CatLiZi/DeepSight-3D/docs/report/README.md

# 项目进度与评估报告

- [项目阶段汇报](index.html)：硬件、架构、算法及按时间保留的历史进展；页面顶部新增2026-11-05的R52互斥优先模式，历史章节保留原日期。
- [R52听声／视觉优先模式](primary-modes-r52.html)：声音主导与可打断视觉辅助、软件验证和两人现场复核步骤。
- [项目整体评估](assessment.html)：模块成熟度、P0–P2 待处理项、验证边界和无需精确量角的现场测试方案。

以上报告是可用浏览器离线打开的公开脱敏快照。GitHub 文件页面通常显示 HTML 源码；下载或克隆仓库后打开本目录中的文件即可查看页面。公开版不包含现场人物照片、原始录音、私人设备日志及机器用户路径；模型图使用仓库中的 CAD 渲染。历史原始证据未全部发布，报告中提及的本地证据目录不代表仓库中存在这些文件。

2026-11-05 根据要求清理了 V17 头部和 V25 身体 Blender 模型内的历史账户路径：当前模型的可表示目录使用 `//` 相对路径，未使用的历史路径残留被清空。模型重新打开并核对对象、网格、材质和依赖清单，几何未变；当前哈希见[模型清单](../../hardware/cad/panda_source_manifest.json)。

R51公开版本的历史复核完成 859 项 Python 回归、104 项前端检查和 240 组几何模拟；这些是软件结果，不是实物声源或机械精度验收。

项目仍是室内演示候选；软件测试与现场验收的范围分别记录在报告内。声学零位、机械端点、多人和远距离等仍需继续验证。

R52与D1录制的本次发布复核见[904项Python／123项前端检查记录](../VALIDATION_R52.md)，新增[三段英文演示文案](../DEMO_DIALOGUE_EN.md)。旧验证数量不与本次相加。

现行模块和图稿交接：[R52算法架构说明](../ALGORITHM_ARCHITECTURE_R52_CN.md) · [给制图agent的提示词](../AGENT_PROMPT_FRAMEWORK_R52_CN.md)。旧总图暂保留为R51历史参考；本轮没有改变执行算法或重绘模型结构。

[R53回中与手动控制修复](../CONTROL_OWNERSHIP_R53_CN.md)：自动暂停时保留手动轨迹、服务端统一中位、918项Python和127项前端验证。
