CatLiZi/DeepSight-3D/docs/AGENT_PROMPT_FRAMEWORK_R52_CN.md

# 交给另一个agent：更新R52算法框架图

以下分隔线之间为可直接复制的完整提示词。本提示词只安排制图和展示文档更新，不要求修改可运行算法或控制实物。

---

你负责“深瞳计划 / DeepSight-3D”的算法框架图和技术展示资料。请按照当前R53源码（继承R52感知与双主模式），更新已有算法框架；不要沿用旧版固定“视觉优先”的总图。R53进一步修复了暂停期间手动动作被感知逻辑撤销的问题，请补读`docs/CONTROL_OWNERSHIP_R53_CN.md`：自动撤销须有运行权限和当前代次，手动回中使用服务端保存中位及两轴反馈。感知和双主模式结构仍按本R52交接说明。

## 项目与核对基线

- 唯一仓库：https://github.com/CatLiZi/DeepSight-3D
- 至少包含算法提交 `5b47c00dcdf43a913c95d89e35f2bf6aab99b88b`（R52 + D1）；更新文档的提交可以在其后。若本地已有更新版本，先核对源码，再决定哪些文档需要修正。
- 优先阅读：`docs/ALGORITHM_ARCHITECTURE_R52_CN.md`、`docs/CURRENT_RELEASE_CN.md`、`docs/VALIDATION_R52.md`、`docs/report/primary-modes-r52.html`。
- 对应源码：`src/locator_demo/audio_primary.py`、`visual_priority.py`、`dominant_sound.py`、`pair_fusion.py`、`array_pose.py`、`audio_policy.py`、`stereo_vision.py`、`binocular.py`、`fixation.py`、`visual_servo.py`、`motion.py`与`web/app.py`。录制参考`demo_recording.py`、`web/demo_recording.py`和`web/static/demo_recording.js`。
- 当前旧图是`docs/assets/system-architecture.svg`，由`tools/build_project_diagrams.py`生成。README.md和README_EN.md引用了它；生成器也必须一起更新。

## 本阶段必须表达的算法结构

1. 保留两条并行感知线：双目同帧采集→每眼检测/多尺度补查→跨目关联与共同注视；四路RAW→Silero人声支持/连续性恢复→分对GCC时差与方向质量→姿态对齐和条件融合→可靠声学证据。
2. 决策层改成两个**互斥主模式**，并画清模式选择入口。互斥的是控制优先级，不是关闭另一种传感器：
   - **听声主导 Audio primary**：可靠声音→核心方向与有限Yaw目标→先转向→接近后在声音范围内关联真实人脸→视觉居中/跟随。新确认声源可以打断旧视觉辅助并撤销旧轨迹。无可靠声音时不能直接选最大脸启动这一模式。
   - **视觉主导 Visual primary**：可信视觉目标优先，声音辅助可见人脸排序；安静或声视冲突时保持视觉。没有视觉拥有者时可回退到已授权的有限听声搜索。
3. 独立画出**核心声源记忆与换人保护**。它按近期有效语音时长、可靠度和新鲜度累计，不是按音量最大选人，也不是声纹识别。声音短暂停顿可以继续完成已确认有限目标；旧方向不会不断累加。显示中的1秒蓝色保留只是显示，不作为新证据。
4. 两种模式汇入同一个受限平滑控制器。视觉微调基于图像误差与图像位移速度，大偏差可大步、接近后减速；不是固定小步，也不是测得了人体真实速度。模式变化/停止/新声源接管/反馈故障有撤销旧动作的路径。
5. 画出反馈闭环：新图像回到视觉纠偏；实测舵机反馈与受约束轨迹历史回到四麦头身坐标转换。标清50Hz是轨迹指令节奏，周期位置反馈约1Hz。
6. **D1录制是旁路**：浏览器标签页画面+已有四路PCM+状态时间线→本机MP4/WAV/WebM/JSONL/ZIP。最长60秒，不另开麦克风，不自动启动运动，不自动上传。演示稿A→B→A共90词，A不动、B讲话时慢移；提词不是实际说话人真值。

## 必须保留的事实和边界

- 左右按小熊自身：CH2左耳、CH3右耳；CH1身体左、CH4身体右。耳距约13.55cm，身体对约7.55cm；4通道48kHz/16bit WASAPI RAW。
- 当前四麦是“移动耳对+固定身体对”的条件协同。身体方向必须先转换到头部坐标；无可信姿态、明显俯仰偏离或声学冲突时回退。不是六对完整三维阵列，不是原始四路波形平均，也没有可靠声学距离。
- 双目3840×1080是采集总分辨率，原始每眼1920×1080，当前对齐共同有效区约1837×1053/眼。60fps为请求档位，不宣称所有时候实收60fps。
- 两眼正常水平视差保留，共同注视点投影回各眼；不为重合画面伪造深度，正式米制距离输出关闭。
- 位置刻度/角度比例约7.407407刻度/度。Yaw控制中位2000与四麦声学参考1952不同；Yaw软件范围1500–2500，Pitch1255–1855、中位1550。这些不是直接的角度和已验收机械端点。
- 904项Python与123项前端检查是软件验证数量，不是准确率。R52已加载核对，实物双人轮流/同时讲话、遮挡、动态四麦全姿态、噪声和远距离仍需现场验收。
- SCRFD、Silero是预训练推理模块。不要画出本项目新训练的端到端网络、ASR/LLM语义理解、声纹身份识别、六对SRP-PHAT或神经跨模态注意力。

## 交付要求

请交付三张一致风格的技术图：

1. **系统总图**：并行感知、统一证据、互斥模式、共享控制、反馈和D1旁路。
2. **模式对照图**：明确“谁有权接管”，用同一情景说明新声音在两种模式下的不同处理。
3. **听声状态图**：`waiting_sound → turn_to_sound → acquire_face → visual_refine`，补上`face_lost`、`hold_sound`、新核心声源打断、模式切换/停止/故障撤销。角度/时间常量可以放图注，不能标为实测精度或端到端延迟。

使用可编辑SVG或现有生成脚本，提供高清PNG/PDF用于汇报；保留源码，离线可用。优先复用README现有深蓝/青绿/浅蓝视觉风格，技术箭头要可辨认，不堆砌装饰。节点中文/英文用语统一，必要时分别导出中英文版。

更新README中英文版的图路径、替代文本和说明；仅在新图核对完成后移除“R51旧图待更新”的提示。注明R52架构＋R53控制修复、制图日期和待验证边界。将文件清单和“节点—源码依据”对照一并交付。

不要改算法参数、可执行控制代码、标定文件或Blender模型；不要启动/停止实体服务、操作舵机或新录现场音视频。不要公开人名、其他学校、账户路径、人脸截图或原始音视频；唯一允许出现的真实机构名称是“深圳河套学院”。保留仓库授权与必要的软件来源说明。此次交付不要求你自行推送或部署，先提供可复核文件。

## 验收清单

- 三张图都能明确区分两个互斥主模式；声音主导图中存在“新确认声源打断视觉辅助”的路径。
- 有限位置记忆、当前声音证据和显示保留分开表示。
- 两眼均参与视觉；四路均采集，身体角度参与标为有条件；没有伪造测距、三维定位或身份识别。
- 存在图像闭环、头身姿态反馈、停止/故障撤销；录制没有启动电机的箭头。
- 所有技术名词、数字和“已完成”表述可在上述源码或验证记录中找到依据。
- SVG无缺字、重叠、截断和无法辨别的交叉线；常见README宽度和PPT投影尺寸下可读。
- 生成脚本可以再生图；本次差异不包含运行算法、实物动作或模型几何修改。

---
