CatLiZi/DeepSight-3D/docs/CURRENT_RELEASE_CN.md

# 当前交付基线：R53 + D1录制

本文件描述2026年11月5日的发布候选源码。README按日期保留的旧“待加载”、旧通道与旧中位仅是历史状态。运行进程版本以 `/api/state` 的 `algorithm_revision` 为准，不能只看磁盘源码。

| 内容 | 当前基线 | 验证边界 |
| --- | --- | --- |
| 四麦 | CH1身体左、CH2左耳、CH3右耳、CH4身体右；48 kHz、16 bit、WASAPI RAW | 两对有条件融合；未完成全姿态三维阵列验收 |
| 双目 | 同屏3840×1080，MJPEG，请求60 fps；共同画面1837×1053/眼 | 正式米制测距关闭；实收帧率及同步曝光另行验证 |
| 舵机 | Yaw ID0：1500 / 2000 / 2500；Pitch ID2：1255 / 1550 / 1855 | 2026-11-04 的软件刻度，不是角度；机械边界待现场确认 |
| 比例 | 2000/270 ≈ 7.407407 刻度/度 | 来自用户提供的舵机规格，尚非装配后实测角度标定 |
| 运动 | 听声主导／视觉主导互斥，50 Hz平滑轨迹、反馈检查 | 50 Hz不是位置反馈频率；无反馈时仍停机 |
| 语音 | R49语音恢复包含在本版本中 | 轻声、远距、运动噪声和多人仍需进一步验收 |

左右以小熊自身为准。[当前装配示例](../configs/panda-assembled-r52.example.json)默认使用仅预览模式并关闭相机开关，首次复制到本机设置后需由操作者检查设备映射与行程。配置已存在时不要覆盖。

水平控制中位 2000 与四麦头身声学参考 1952 各有用途，不能互相替代；如果重新装配改变了头身正前方关系，需重新检查声学零位。新软件限位不代表机械端点已经通过测试。[公开阶段汇报](report/index.html) · [公开整体评估](report/assessment.html)

## R53回中修复

修复了R52在自动跟随暂停时，后台声音/视觉状态变化仍可能取消手动回中、点动和姿态轨迹的问题。自动撤销现在同时检查运行权限与控制代次；后端新增统一回中接口，采用保存的2000/1550中位并先核对两轴反馈。

918项Python回归、127项前端检查通过；用户正常重启R53后已确认回中正常，接口显示轨迹完成且两轴反馈有效。Stop和反馈保护、两种主模式、四麦、相机、行程与平滑限制保留。[控制修复与验证](CONTROL_OWNERSHIP_R53_CN.md)

## 现行架构与展示资料

[R52算法架构与模块说明](ALGORITHM_ARCHITECTURE_R52_CN.md)记录当前数据流、控制拥有者、听声状态机、两对四麦条件融合、反馈和D1旁路。[制图agent提示词](AGENT_PROMPT_FRAMEWORK_R52_CN.md)可直接交接。

原`system-architecture.svg`与生成器仍是R51固定视觉优先版本，已在中英文README标为历史图；本轮更新说明文档，重画框架图由另一位agent按交接提示词完成。不要把旧图当作R52完整路径。

## R52与D1更新

- “听声转头”改为声音主导：可靠声源生成有限转向目标，转近后由对应人脸进行视觉微调；新确认的声源可以撤销旧视觉跟随并接管。
- “视觉跟踪”保持视觉主导、声音辅助选人。两种主模式互斥，模式选择与传感器采集分开；仅预览不代表停止后台麦克风采集。
- 短暂停顿不取消已确认目标；长期没有新声音时，不无限期招募后来进入画面的人脸。旧模式、旧声源轮次或过期画面不能继续控制。
- D1录制保留网页画面、四路WAV、耳部两路立体声MP4和目标时间线，最长60秒，只存本机。录制按钮不启动运动。
- 英文演示文案为A→B→A三段长发言，共90词；A固定、B在自己发言时缓慢移动。页面提词与稳定的计划段落编号同步。
- 修复Windows录制导出状态文件的读写竞争。

本机已只读确认R52加载、四麦RAW与双目在线、自动动作暂停。**904项Python回归与123项前端检查通过**；实物双人切换尚未验收。[R52验证记录](VALIDATION_R52.md) · [模式说明HTML](report/primary-modes-r52.html) · [录制说明](DEMO_RECORDING_CN.md)

## 保留的R51更新

- 保留R50完整听声目标、分段到位和停止/视觉接管保护。
- 本机 HTTP / WebSocket 控制台拒绝不匹配的跨来源浏览器请求。无 `Origin` 的本地命令行客户端仍可使用；这不是对本机其他进程的身份认证。
- 适配仓库内标定板 PDF 和打包回归测试资料，修复新检出项目找不到文件的问题。
- 整理双语项目说明、基于仓库模型的结构渲染和框架图。

R51历史检查保留在[原验证记录](VALIDATION_R51.md)，不与本次测试数量累加。新检出代码需要操作者正常启动并确认版本后再做现场测试。

## 启动与版本核对

请按[主README](../README.md#快速开始)中的步骤，在仓库根目录运行 `python -X utf8 .\run_server.py`。如果已有旧服务，先在原终端正常按 `Ctrl+C`；不要同时启动多个实体进程。

网页先保持自动转头关闭，确认实际加载R53、设备与两轴反馈，再进行受控复验。下载包中的双目配置只适用于原装配参考，镜头或外壳移动后应重新检查。

## 可复现交付

`tools/export_release_manifest.py --output <目录>` 只读取源码、模型、标定、配置与依赖版本，不访问硬件。环境清单不是已经通过干净安装验证的跨机器锁文件。新机器部署、GPU/驱动兼容性、机械边界和实物声源准确性仍需分别验证。
