CatLiZi/DeepSight-3D/docs/FOUR_MIC_FUSION_CN.md

# R44 四麦协同定位

> 范围说明（2026-11-05）：本页保留原阶段设计与验证记录。当前R52整套路径以[算法架构说明](ALGORITHM_ARCHITECTURE_R52_CN.md)为准；视觉优先仅是两个互斥主模式之一，不能用于解释听声主导的接管规则。

> 历史R44记录：当前配置及运行状态请以 [R52交付说明](CURRENT_RELEASE_CN.md) 为准；旧R44示例不包含R50后的物理偏航比例。

身体左 CH1 / 右 CH4 已接入，与左耳 CH2 / 右耳 CH3 同一四路原始采样窗口。两对分别做人声检测与时差估计，不将相隔位置的波形直接下混。

身体信号与耳部具有同源频谱一致性时，可辅助可靠频段并补充耳部人声漏检；原双耳路径独立保留。身体方向只有在有效位置反馈和名义中位对齐，或已有实测Yaw刻度/角度映射时，才换到头部坐标参与融合。未获得映射的其他转头姿态仍提供频段和人声辅助，并显示身体坐标中的独立方向。

本机配置已设置 localization_mode=four_mic、身体左1/右4、间距0.0755m、映射确认；两耳2/3、间距0.1355m和延迟零点0保持。实测Yaw每度刻度留空，禁止用控制增益代替。需要正常重启后生效；本次未代停/重启服务、未移动舵机或新录音。

719项Python、87项前端和70组独立模拟通过。真实录音回放7567个窗口，原有效方向无丢失；现场四麦角度准确性、前后区分、多说话人和正式声源测距没有新增验收。

详细说明：`../../hardware_inventory/four-mic-fusion-20261029/index.html`。实机配置快照：`../configs/panda-final-r44.json`。生产新模块为 `pair_fusion.py`，现有采集、配置/API和网页均已接入。
