CatLiZi/DeepSight-3D/docs/AUDIO_DECISION_POLICY_CN.md

# R48 听觉判定规则

当前四麦主运行链路的实际规则集中在 src/locator_demo/audio_policy.py。

- 窗内语音支持分达到0.45才尝试时差计算；这是定位入口，不是转头许可。
- 默认可靠语音要求0.50，综合和方向质量均至少0.20。网页提高要求会传到各环节，降低到保护下限以下则归一并回显实际值。
- 两对麦克风方向合并的方向质量额外下限0.25，由共享规则给出，界面说明用途。
- 动态时效0.35秒、稳定度0.5、角度不确定度25°、核心声源/选人的连续确认保留。输入有能量不是已定位；图形历史保留1秒不是新控制证据。
- 新数据最少次数是核心和选人的最低观察数量；原有阶段时间确认仍在，不能靠设1跳过。

旧配置 speech=0.15、doa=0.05会归一为0.50、0.20，API、网页和保存配置一致。迁移备份在 hardware_inventory/audio-policy-20261103/settings-before.json。

页面同时展示窗内语音证据、方向可靠性与当前为何不动。解释数据只读，不授权舵机。可靠声音在运动中仍然可用；已确认目标的有限转向不因显示端声音消失被取消。

修改要求时取消旧动作和确认、重置独立DSP与VAD历史；不重开采集设备。仅录音设置变化不重置语音历史。

790项回归、96项前端检查通过，4625个原录音默认输出不变，12组模拟反例无可用方向。静止/运动下提高门槛均阻止低于新要求的原始声音进入核心转头。旧双声道适配器保留兼容，不作为当前四麦采集源。先前轻声录音的输入听感问题、远距离及转动噪声另行验证，不能据此宣称解决。
