CatLiZi/DeepSight-3D/docs/report/index.html

跳转至报告正文

DDEEPSIGHT-3DAUDIOVISUAL ROBOT HEAD

打印 / PDF汇报模式 ↗

R53控制修复：回中与手动轨迹不再被暂停期间的感知逻辑取消。 统一服务端回中入口，保留Stop/反馈/行程保护。918项Python、127项前端检查通过，用户已确认回中正常，位置反馈有效。修复依据与复核步骤R52架构说明与制图交接已补充。 当前模块说明 · 给另一agent的完整提示词。旧视觉优先总图已标明历史范围，新图由另一agent更新。R52 · 2026.11.05：新增互斥的听声主导／视觉主导。 听声模式先转向可靠声音，再用对应人脸微调，新声源可打断旧跟随；903项Python回归与122项前端检查通过。查看设计、验证边界与现场复核方案。加载状态以控制台版本为准；历史章节保留原测试日期。公开脱敏版：保留项目进度和验证边界；现场人像、原始录音、私人路径与局部截图不公开。图片占位不代表实物采集效果。

R51 研究原型 · 室内演示候选状态核对 2026.11.04

Perception · Decision · Motion

# 视听感知人头 阶段进展报告

围绕“听到方向、找到目标、调整朝向”，构建视听协同的双轴人头系统。头部实物已完成装配，左右目同时识别。当前以视觉确定目标和转向，声音提供有限搜索扇区；无声或没有对应时按视觉选人。转头按新画面的偏差逐段逼近，保留连续轨迹；正式距离继续关闭，真人选人、物理顺滑度和角度精度仍待验收。

查看升级硬件参数 ↓查看本轮验证结果 ↗

依据真实采集、源码与离线测试整理，可独立离线打开。

SYSTEM / FUNCTIONAL VIEWCAMERA × MIC ARRAY

感知与控制功能示意架构依据当前项目源码

双目同屏总分辨率3840 × 1080每眼 1920 × 1080 · 完整双目保留

摄像头请求驱动档位60 fps / MJPEGR28 · 近期实采 49.60–49.65 fps

麦克风采集通道4 通道四路全部保留 · WASAPI 共享模式

音频采集格式48 kHz / 16 bitRAW · 重插后采集恢复

当前软件进展

新硬件身份识别、完整双目采集、四通道录音验证、现有算法梳理与升级规格确定。以下分别展示硬件实测和当前软件实现。

01 / Hardware configuration

## 先确定采集规格， 再以此升级算法。

本轮选定的两项核心硬件参数。摄像头完整保留左右目，麦克风完整保留四个通道。

SPECIFICATION / 2026.10.28

STEREO CAMERA主程序采集已接入

### SC233HGS 双目

彩色 · 112° · 手动调焦 · USB 视频

已选摄像头参数
双目同屏分辨率 | 3840 × 1080
每眼分辨率 | 1920 × 1080左右拼接，同一输出帧包含两幅画面
请求驱动帧率 | 60 fps目标每秒 60 对左右目画面
采集格式 | 原始 MJPEG copy
R28近期到帧 | 49.60–49.65 fps重启后6次只读状态检查；不是持续60fps验收

R28近期采集 49.60–49.65 fps，双眼推理 11.01–11.22 fps。历史R15短窗 33.12 fps、R13 59.81 fps；不同窗口与设备状态不能归因于某一次算法改动，持续60fps尚未确认。

USB MICROPHONE ARRAYR28 · RAW采集及正常讲话已检查

### YDPI4MIC 四麦

四通道模拟硅麦 · USB 音频采集板

已选麦克风参数
采集通道 | 4 通道四路全部保留
采样率 | 48 kHz每通道每秒 48000 个采样点
位深 / 编码 | 16 bit PCM
Windows 接口 | WASAPI 共享模式
R12 连续录音基线 | 722880 个采样帧约 15 秒 · 缓冲溢出 0 · 录音丢块 0

当前左耳CH2、右耳CH3、身体左CH1、右CH4均参与；身体方向按姿态和质量有条件融合。轻声、动态姿态、多人及远距离仍待独立验收。

设备名称与硬件 ID

摄像头 / USB Video DeviceUSB\VID_1BCF&PID_0B15&MI_00

麦克风 / YDPI4MICUSB\VID_EF09&PID_459D&MI_00

本次麦克风板串口为 COM5 / MI_02；舵机板为 CH340 / COM3（VID 1A86 / PID 7523）。端口号会随插拔改变，按硬件 ID 区分。

采集层已接入主程序

本机与示例配置均已更新。原始双目与四路音频完整保留，采集和推理独立运行；逐眼修正方向，两眼共同识别并选择稳定观察；耳部与身体两对均已接入时差定位，动态姿态与双目深度仍待验证。

### V17 头部：从模型到实物

头部已装配

公开版使用头部与身体的 CAD 组合渲染。

现场照片不随公开版提供；此后身体与两只身体麦克风已装配。

CAD 名义参考：两耳中心约131.76mm，镜头中心约82.08mm。当前声学工作间距按操作者实物估计采用135.5mm，未作精密量测。模型尺寸不代替实物声学或双目标定；最终头身结构已装配；身体左CH1、右CH4的四麦协同见R44更新。

02 / System architecture

## 从感知输入，走到头部动作。

系统以 Python 为核心，包含设备采集、感知、策略、控制及 Web 状态界面。点击模块可查看实现范围与对应代码。

INPUT → PERCEPTION → ACTION

视听感知与连续两轴控制架构独立采集 · 最新帧推理 · 后台总控 · 50 Hz 轨迹

头部朝向变化 → 下一轮声音与画面 → 继续感知与决策

Python / 感知与总控音频定位、人脸检测、目标选择、状态机与运动逻辑。

FastAPI + WebSocket / 状态界面传递画面、检测目标、状态和可配置参数。

pyserial / 舵机总线向 yaw 与 pitch 舵机发送位置和动作时长指令。

03 / Algorithms in the current code

## 当前代码，怎样听、看、选、动。

双目分别检测并按可靠性关联；耳部与身体两对麦克风按姿态和质量有条件融合。正式米制测距关闭。点击查看当前实现及验证边界。

R51 · 2026.11.04 运行快照

查看对应源码位置

公开版提供算法简要说明；完整评估见独立报告。历史回放和模拟结果不代表真实场景识别精度。

查看算法简要说明 ↗

04 / Recorded measurements

## 用真实采集结果，说明当前进展。

统计结果来自已保存的测试记录；公开版保留脱敏汇总与模拟轨迹，不提供现场样张或原始录音。

RECORDED ON 2026.10.28

LATEST / 2026.11.04

### R50–R51：听声目标几何、发布与当前设置

R51 已加载 · 状态快照

R50将完整听声目标与分段步幅分开，并采用用户提供的舵机规格约7.4074刻度/度；短句后的已确认目标可以继续分段完成。R51增加网页来源保护并整理仓库交付，听觉与视觉算法继承R50。当前仍定位为研究原型 / 室内演示候选。

四路声音 | 耳左CH2、耳右CH3；身体左CH1、身体右CH4两对分别估计时差；身体方向仅在姿态、质量可靠时融入。不是完整三维定位或可靠声源测距。
左右舵机 ID 0 | 1500 / 2000 / 2500下限 / 控制中位 / 上限；左右各500刻度，软件限位未等同机械边界验收。
俯仰舵机 ID 2 | 1255 / 1550 / 1855总范围600；从控制中位到两端分别295和305。头身Yaw声学参考仍为1952，是否需要重新标定待确认。
证据与版本 | R51：855项Python回归、104项前端检查；另240组几何模拟来自2026-11-04发布记录，不是本次新做的现场验收。源码和CAD曾核对提交85275f4；2026-11-05仅清理模型中的旧电脑路径，几何与对象结构复核一致。

23:37只读快照：R51正在运行，四路RAW活跃；相机该时刻约49.98 fps，请求档位60 fps。运行状态与帧率会变化。现场体验已获用户正面反馈，短句转向、多说话人、远距离、动态四麦、偶发无反馈和机械端点仍需分项验证；目测左右不作为精确角度真值。

更完整的算法评估、P0–P2问题与现场测试方案：打开项目整体评估报告 ↗。下方R49及以前的内容均是各阶段历史记录，不代表当前状态。

现场实物图仅保存在本机；公开版不附照片。

V17头部与V25身体模型组合渲染

V17头部与V25身体CAD组合渲染；不代表机械公差验收。

## R49 · 自然音调的辅助语音恢复

2026-11-03：用户反馈高音调更容易触发。现场录音复现了正常/较低音调入口漏检；本轮完成候选实现与离线验证，当前服务仍为R48，R49待用户正常重启。没有新增实体录音或舵机动作。

### 实现：保留原路径，增加严格的恢复通道

四路原始PCM同时进入原R48路径与同一Silero模型的辅助路径。原路径已可靠的输出原样优先；辅助使用两组相差4秒、各每8秒更新的神经上下文，避免只依赖某一段长期状态。两路物理麦克风的时差、相干性、竞争峰和连续性仍使用原始波形计算，没有降噪后相位替换或波形混音。

主通道人声要求仍为0.50、尝试定位0.45。辅助恢复要求至少0.70（若用户设得更高则跟随用户要求），另需相干成分的频谱包络变化、原始双麦物理时差证据，至少3次新PCM确认且跨120毫秒；用户增加观察次数也会同步提高辅助要求。频谱变化仅用于排除固定谐波/音量调制，不单独证明有人说话。真实语音目标仍受视觉优先、核心方向和舵机反馈保护约束。

### 真实录音回放：与冻结R48相比

大致测试阶段 | R48可用方向窗口累计 | R49可用方向窗口累计
正常音调 | 0.32 s | 0.88 s
自然较低音调 | 0.92 s | 1.60 s
自然较高音调 | 2.68 s | 3.08 s

区间来自操作顺序与录音时间线，含自然停顿，不是逐帧人工语音标签。累计窗口时长不是识别准确率，也不表示现场跟随已经验收。在线隐藏状态与从文件重新开始的状态不同，因此不把重放分数等同于原在线分数。准备与结束区段均没有新增方向。

### 验证与保留条件

816项Python回归、100项前端检查通过。7段录音共17600个窗口，原1327个可靠输出逐字段完全保留，新增88个可用方向窗口；耳部与身体摩擦录音未新增方向。53组合成反例包含9组最终方案冻结后新生成的带噪谐波测试，辅助恢复新增可靠方向为0。主通道、控制、反馈与舵机轨迹文件及关键提交方法保持，摄像头、双目几何和保存参数未变；继续使用同一固定哈希的Silero模型，无新模型部署或训练。

运行代价：辅助增加4个独立VAD状态实例，仍使用同一份权重。本机并发离线测试中，每40毫秒输入窗口的处理耗时P95约12.9–26.7毫秒；这不是在线与视觉同时运行的延迟验收，重启后还需观察采样与控制周期。

### 仍未解决，明确保留记录

原主通道对部分与人声谐波结构相似的合成调制音仍会误报。本轮保留原通道可靠输出，未顺便更改这套原判定；合成反例中累计3179个原主通道可用方向窗口继续如实记录，不能宣称整个系统对53组反例均零输出。新增辅助分支没有增加这些窗口。这是后续噪声辨别与视听关联需处理的已知问题。

正常/低音调的实际体验、远距离、多人轮流说话、真实转动自噪声与实物机械效果待现场确认。本次没有改变两耳13.55cm、身体7.55cm、头身转角比例、通道CH1身体左/CH2左耳/CH3右耳/CH4身体右，或舵机行程与50Hz平滑规划。

已舍弃：直接增益、直接替换TEN检测器、要求两麦神经分数同时很高、只用单个周期、没有相干谱包络保护的交错上下文，以及过严的双频段硬门槛。候选通过收益和反例后才保留。8秒上下文更新为本项目的工程设计，不是厂家给出的通用最佳参数。

## R48 · 听觉判定规则与控制原因统一

2026-11-03：主运行链路使用共享AudioDecisionPolicy。网页、API和保存配置返回实际生效值，旧人声0.15/方向0.05归一为可靠性下限0.50/0.20，保留迁移前配置；没有降低已有可靠性保护。调高人声、综合或方向要求后，DSP尝试门槛、四麦各独立路径、运动中判定、核心声源、视听选人和蓝色范围显示一致遵守。正常旧双声道适配器只作兼容对照，不是当前四麦输入。

阶段 | 默认实际要求 | 用途
尝试计算方向 | 窗内语音支持分≥0.45 | 动作人声要求减0.05，最低0.45；不等于允许转头
可靠语音用于动作/选人 | 语音支持分≥0.50、综合/方向质量各≥0.20 | 网页可提高要求，低于保护下限时归一并显示实际值
合并两对方向 | 方向质量≥0.25，或更高的用户方向要求 | 多一条独立空间约束，额外门槛用途明确
数据与动作保护 | 时效0.35秒、稳定度≥0.5、不确定度≤25° | 固定保护；另需核心声源/跨人脸连续确认和有效舵机反馈

输入电平不等于人声，人声证据不等于可靠方位，可靠方位不等于本次必须转头。网页用同一窗内支持分显示语音条与解释，保留声音范围1秒只作显示。新增只读判定链：语音证据→方向原因→控制原因，区分暂停、听声开关关闭、视觉优先、核心确认、目标已到、搜索预算/行程边界及舵机故障。新页面不产生新控制指令，短暂unknown也不会因显示逻辑取消已确认目标。

统一调高门槛时会清理旧确认与DSP历史，但只切换录音开关不会重置持续VAD。核心和选人分别有各自的时间确认，网页“新数据最少次数”是最低观察次数，不能跳过阶段确认。连续性分支只从低概率窗口学习噪声，独立兼容基线保持R46/R47行为；未把这两条噪声参考伪装为完全相同算法。

790项Python回归、96项前端检查通过；包括调高门槛在静止/移动和选人/融合/转头路径中均生效、无效数值、暂停与历史目标解释、纯文本渲染，以及配置迁移。4625个真实录音窗口在默认要求下与冻结R47逐窗完全一致；12组静音/相关或独立噪声/纯音/调制音/脉冲反例无可用方向。运动规划、舵机底层、反馈轮询和动作提交、相机采集与几何代码未改，行程和7.407407刻度/度保持。

用户正常重启后，已只读核实服务加载R48，自动转头暂停。三次状态核验确认四路48kHz/16bit WASAPI RAW持续采集、全部通道参与、无缓冲溢出，配置与实际门槛一致，新判定说明已由网页返回。详见loaded-verification.json；本次未进行受控人声或实体转头验收。本轮没有实体动作、新录音或代停重启服务。这次修复规则与解释不一致，不代表此前轻声输入听感问题、远距离或电机噪声性能已通过。

## R47 · 四麦水平转头动态坐标融合

2026-11-02：修复周期位置反馈与总线缓存分离导致融合误判反馈过期的问题。身体坐标声源角减去头部相对身体的Yaw角，转换成头部坐标后再与双耳方向融合。静止时使用实测反馈位置；移动时，使用实测反馈约束的轨迹历史，对齐到192ms声音窗口的中间时刻，并将窗口内转角与反馈残差计入姿态不确定度。这里的动态姿态是有反馈约束的估计，不是新增姿态传感器的测量。

新增实测正前方反馈刻度字段，避免用指令中位代替实际反馈零位；三点转角标定工具根据独立实测角度求比例与零位，检查两侧、拟合残差和方向一致性，配置保存前留备份。未标定时保留中位合并和四路频段/人声辅助，不能假装任意姿态角度已经可用。

更新网页显示：头部相对身体转角、身体声源换到头部坐标后的角度、音频时刻对齐状态。反馈丢失、过期、轨迹与反馈差异过大、窗口转角过大或大幅俯仰几何未验证时，停止该次身体角度合并，保留双耳及声学辅助；不整体禁用运动期间声音。

验证类型 | 结果 | 边界
代码回归 | 762项通过，0失败/错误/跳过 | 包含反馈缓存、时钟、会话、移动和标定反例
前端检查 | 90项通过 | 包含3项新增动态角显示断言
独立已知角模拟 | 52组通过 | 使用已知旋转和模拟语音许可，不代替实机角度标定
真实录音回放 | 4625窗输出与冻结R46完全一致 | 无动态姿态真值，只验证原听觉输出不退化
控制链路 | 运动规划、舵机底层、反馈轮询节奏及动作提交代码一致 | 本轮未发送实体动作

用户已补充500→0°、1500→135°、2500→270°参数，现已配置2000/270≈7.407407刻度/度；“pwm150”按其余点一致性解释为1500。用户确认的装配后正前方Yaw1952作为头部相对身体0°，不把厂家绝对135°位置当成人头正前方。参数来源为用户提供规格，尚非独立实测动态标定。用户正常重启后已核实R47加载，7.407407刻度/度和Yaw1952零位已生效。两轴只读反馈连续三次为Yaw1958、Pitch1563，均正常；本次未下发动作。自动转头仍暂停，尚未进入运行时两轴姿态同步；实际动态融合效果仍待现场验证。水平转头后的实物动态融合、明显俯仰下的三维几何尚未验收。本轮不修改人声模型或门槛；另行发现的轻声输入问题仍待回放听感确认。

## R46 · 语音连续性：当前音频窗证据补充

2026-11-02：定位分析约192毫秒PCM，但原门槛只用末尾神经网络块的分数。新处理在同一PCM窗内取真实已观测分数的最大值，原始瞬时概率单独保留；这属于窗内语音支持分，不是重新标定的人声概率。超过窗口、断档或重启不能继续借用。方向仍从当前PCM重新估计，不延用旧方向。

新增独立噪声/时差历史，概率0.10至0.45的不确定输入不训练新增分支的噪声参考；0.45定位门槛和0.5融合门槛未降低。原R45可靠输出优先且逐窗保留，新分支只补原输出不可用且当前声学证据仍可靠的窗口。首版替换方案因发现旧有效窗口丢失而弃用，证据目录保留。

录音回放 | 原可用窗口 | 新可用窗口 | 旧窗口丢失
开发材料 | 168 | 243 | 0
独立正前方 | 482 | 516 | 0
独立左右 | 392 | 470 | 0
独立身体摩擦 | 0 | 0 | 0

四份录音共8525个40毫秒步长窗口；独立人声材料可用窗口874→986，原有效角度逐窗不变。以上是可用输出数量，不是准确率/召回率：材料没有精确语音帧或角度真值标注。12组静音、独立/相关噪声、纯音、调制音和脉冲反例均未输出可用方向。734项Python回归、87项前端检查通过。回放计算均值约9毫秒/40毫秒步长，静止现场补充效果见下方记录，运动负载仍待确认。

源码R46已验证，已由用户正常重启，核实R46加载且自动转头暂停；静止正常讲话的现场数值检查已完成。未代停重启服务，未采集新录音或发送舵机动作；视觉、角度转换、舵机轨迹和硬件参数保持。

现场静止讲话数值联调：233秒、931次约250毫秒间隔状态采样。两段正常讲话期间原可靠处理窗分别保留142/79个，新增分支分别补充53/34个；方向中位数分别右约0.96°/0.79°，仅描述实测输出，不作角度误差真值。结束后的29秒尾段全部为unknown，补充计数未继续增长。采样时钟正常、溢出0，没有转动指令或新增录音。

已确认正常讲话的窗内补充在实机生效。此次数值采样未标注精确人声起止，不能据此宣称所有音节零漏检或精确退出延迟；移动、电机自噪声、轻声远距离和多人重叠仍待验证。

## R45 · 四麦现场联调

2026-10-30 正前方、右前方→左前方两轮已录制，无溢出或录音丢块。正前方双耳约右2.6°、身体约左3.0°；右前方双耳约右27.7°、身体约右26.4°；左前方双耳约左12.2°、身体约左17.4°。站位为目测，不是精确角度真值，未按这些值改零点或拉伸角度。

已复现回中反馈偏6刻度被5刻度中位门槛挡住，源码R45将容差改为8刻度；仍要求反馈新鲜、没有转动及位置在范围内。720项Python回归、87项前端检查通过。用户正常重启后已核实服务加载R45；静止中位复测已看到身体方向进入融合。

重启后的第三轮：正前方双耳右约1.6°、身体左约6.4°；左前方双耳左约22.8°、身体左约25.8°。共397个约0.5秒间隔的状态采样中，8次显示身体方向已用于融合；这些是状态快照，不能当作全部音频处理帧数。诊断期间约每秒只读刷新两轴真实反馈，未下发转动指令；反馈中位条件接受389个采样。用户确认站位为估计，不能算角度准确率。

无溢出、丢块或削波。连续20毫秒PCM回放仍出现人声概率断续，说明断续现象可在保存输入与现有检测器上复现；尚不能据此计算漏检率或排除所有实时影响。本轮未降低门槛或引入新增益。下一步需要带人声时段标注的独立回放反例验证。转头后的身体角度转换仍需要实际转角比例；本轮只验证静止中位融合。

R44 · 2026-10-29

## 身体 CH1 / CH4 已接入四麦协同定位

已核实 R44 加载，四路均进入分析

身体左CH1、左耳CH2、右耳CH3、身体右CH4分别保留原始信号。两对独立人声检测、独立时差估计，以跨对频谱一致性补充可靠频段和漏检人声；原双耳结果独立保留，身体故障不拖累可信双耳方向。身体角度在坐标可对应时参与融合，两对冲突时保留双耳。

719项Python回归、87项前端检查、70组独立模拟通过。两份录音7567个40ms窗口回放，原有有效方向无丢失；身体摩擦录音无新增有效方向。语音素材中的身体通道当时尚未固定，因此这些回放不代表最终四麦实体测角通过。

头部中位且反馈有效时可按名义对齐合并身体方位；转角比例留空的其他姿态，身体继续做人声和频段辅助。完整跨头身几何、实测舵机角度映射、现场多说话人及精确方位仍待验证。此次没有舵机动作或新录音。

查看四麦协同说明、结果表与加载步骤 →

R43 · 双目共同注视

## 两眼各自跟踪同一张脸，保留正常视差

修复固定中心准星与控制目标不一致：黄色准星落在各眼对应的脸部特征上，绿色圆环显示各眼期望落点，灰色小十字仅表示画面中心。可靠双目匹配使用共同方向控制；遮挡、歧义、过期结果不伪造第二眼。

690 项 Python 回归、75 项前端检查通过；8 组保存实景回放均匹配，6 帧完成连续确认。新代码 R43 待正常重启，当前只读观察为 R42；未发送舵机动作。平滑控制、行程、音频与最终装配标定保持不变，实物跟随效果待确认。

打开离线准星对照预览与验证说明

2026.10.28 · 最终装配复核

## 双目已更新，四麦按活动结构接入

新的双目对齐数据已在当前 8010 服务加载，无需为此再次重启。算法源码仍为 R42、正在运行的是 R41；此前 R42 的控制配置修复仍待正常重启加载。自动转动保持暂停，本轮没有发送舵机转动或使能指令。

事项 | 本轮结果 | 验证范围
最终装配双目 | 校正相对旋转，统一裁切至每眼 1837×1053 | 实物标定图 + 新拍画面检查通过，已加载
四麦融合 | 完成两对独立定位及统一坐标关联的离线原型；11 项软件测试通过 | 未接入现场转头；耳部 CH2/CH3 继续负责实际定位
舵机通信 | ID0 / ID2 各 12 次查询成功，均为 1952 / 1555 | 只读反馈；没有做新行程或机械顺滑度验收
代码回归 | 676 项严格回归通过，0 失败、0 跳过 | 本轮未修改生产 Python、平滑轨迹、方向和行程设置

### 1 · 这次双目对齐改了什么

329 对原始同屏采样中，74 对检出至少 12 个共同 ChArUco 角点，最多为全部 54 点。采用 22 帧标定点及背景约束调整相对旋转；相机内参、畸变和原有平移向量保持不变。另有 39 帧用于同一轮检查，末尾较低位置的 13 帧保留检验，拟合结束后又新拍 8 帧复核。重复帧并不等于独立姿态数量。

未参与拟合的检查 | 之前的垂直残差 P95 | 之后的垂直残差 P95
13 帧下方标定板 | 5.50–6.58 px | 1.02–2.59 px
8 帧拟合后新画面 | 6.30–7.91 px | 2.05–2.84 px

加载后，网页现有对齐检查连续 3 帧均为正常。共同画面保留原始每眼像素面积的 93.29%。下图上半为之前，下半为之后；绿色水平线便于比较高度。

这是垂直对齐残差，不是整套内参标定的重投影误差。左右位置差是正常视差，应当保留。手持纸张的平整度和打印尺度未正式验证，因此本次没有开放米级距离输出，也没有验证传感器曝光同步或整个视场的绝对精度。算法基于 OpenCV 相机校正接口 (https://docs.opencv.org/4.13.0/d9/d0c/group__calib3d.html)。

候选方案与检查局限

先试的纯背景五参数拟合，在近处标定板上仍残留较大误差，未采用。最终选择更简单的固定平移、仅修正旋转方案。早期背景匹配出现少数重复纹理误配；原始残差和排除数量均保留在实验记录中。最终验收同时依赖带编号的标定点和拟合后新拍图像，没有只报告训练帧误差。

### 2 · 四声道怎么融合

通道 | 实物位置 | 处理方式
CH2 / CH3 | 小熊左耳 / 右耳，间距 13.55 cm | 头部坐标中的双耳方向；随头一起转动
CH1 / CH4 | 小熊身体左侧 / 右侧，间距 7.55 cm | 身体坐标中的方向；保持固定

1. 同一时钟采四路，分别计算两对时差。保留 48 kHz、16 bit、WASAPI RAW。两对各有自己的语音检测、频段可靠性、相关峰和连续性状态，不把四路直接相加，也不让耳朵的人声判定替胸部摩擦信号放行。
2. 先统一坐标再关联。耳部方向跟随头转，身体方向不转。必须使用动作发生时的实际姿态；舵机目标刻度和真实角度不能直接画等号。姿态过期或几何未验证时，身体方向只作诊断，继续使用原来的双耳结果。
3. 比较方向区间及可靠性。两对指向一致时增加支持；明显冲突时保留两个候选，不能平均成一个并不存在的中间声源。对身体较短间距带来的不确定性单独建模，不固定两对各占一半权重。
4. 接入已有的主声源记忆与视觉选人。有效语音时长、方向质量、近期证据和候选差距决定核心方向；声音短暂停顿不取消已确认的转头目标。可靠方向与整张人脸的角度区间匹配，视觉仍优先，大小仅用于相对近远排序。

四路意味着最多 6 个麦克风配对，但耳—身体的四条跨部位基线会随头转动。你提供的同侧 17.7–17.8 cm 是有用的长度约束，还不足以唯一确定前后位置和转轴。先接两对，再考虑完整 6 对 SRP 搜索；SRP-PHAT 官方接口 (https://pyroomacoustics.readthedocs.io/en/stable/pyroomacoustics.doa.srp.html)也要求每个咪头的实际空间坐标。

当前离线原型验证了：两种间距与通道各自生效、身体损坏不会污染耳部、重复数据不累计、过期姿态不融合、头部转角坐标变换、竞争方向不虚构中间峰。它尚未加载到现场控制，也不是新训练的神经网络。现有逐孔摩擦录音只证明接线，不能充当四麦方位正确的验收材料。

约半米的近场交流还要考虑耳与身体中心的平移差，不能只减一个转头角。接入前需要身体两孔的语音左右对照、头姿态到角度的映射，以及最终结构的前后/高度关系。完整 CAD 坐标或少量实际测量均可提供这些信息。正式尺度尚未验证时，不输出声音“距离几米”。

### 3 · 声源角度和多说话人怎么验收

场景 | 操作 | 记录指标
单人、固定头部 | 标出小熊自身左45°、左30°、正前、右30°、右45°；每处正常讲话 8–10 秒，静音间隔 3 秒，随机顺序重复 3 轮 | 方向输出率、反向率、角度中位/P90误差、首次锁定时间；unknown 必须计入缺失率
无语音反例 | 静音、空调/键盘、短摩擦、纯音分别保存；标签由现场操作确认 | 误认人声、误锁方向及不应发生的转头次数
两人轮流说话 | 两人分立两侧，每人说 5–8 秒后轮换；加入短暂停顿 | 锁定正确人脸的比例、切换时延、旧目标是否误覆盖新目标、声音停止后动作是否完成
两人同时说话 | 先一人主讲、一人短插话，再两人音量接近；手机播放仅用于可重复声学测试 | 强干扰下的方向歧义率、目标来回切换次数；不能用播放录音替代真人嘴部与画面的同步验证
头部缓慢转动 | 在机械范围验收后，固定声源、小幅转头，并记录实际位置时间戳 | 统一坐标后的方向漂移、运动噪声误判；声音测量持续运行

角度标签不要只靠目测。沿正前方取距离 z，横向偏移 x 时角度为 arctan(x/z)；例如 z=1 m、x=0.577 m 对应约30°。空间受限可缩为 z=0.5 m、x=0.289 m，并单独记录为近场测试。校准用一轮、验收另留一轮，不能调完参数又只用原样本报成绩。可先以单声源 P90≤15°、有效输出率≥80%作为演示目标，实际数据决定是否达标；这些目标现在尚未通过验收。

### 4 · 偶发舵机无反馈，已经查到哪一层

现有轮转日志保留了 38,467 次位置请求：38,241 次正常回包，202 次超时无回包，24 次串口 I/O 错误。所有失败记录均为零接收字节，未发现“正常位置包被解析器拒绝”的案例。日志含调试、重连和不同时段，不能把这个比例当作新版本故障率。

查看各保留运行时段的请求表

10月28日时段 | 请求数 | 成功 | 无回包 | I/O错误
07:47:03–10:44:13 | 20929 | 20929 | 0 | 0
10:54:29–11:51:40 | 6761 | 6754 | 7 | 0
13:07:04–13:13:03 | 132 | 82 | 38 | 12
13:14:00–14:04:21 | 5273 | 5114 | 153 | 6
14:08:15–14:09:53 | 48 | 42 | 0 | 6
14:10:11–14:11:42 | 28 | 28 | 0 | 0
14:19:19–14:58:28 | 4446 | 4442 | 4 | 0
15:11:21–15:24:58 | 850 | 850 | 0 | 0

当前补查两轴各 12 次均成功，位置为 Yaw1952、Pitch1555。此前 I/O 错误包含 Windows WriteFile failed / 拒绝访问；这提示串口连接或句柄问题，但不能仅凭这条日志断定电源、USB 线或控制板哪一项损坏。pySerial 文档 (https://pyserial.readthedocs.io/en/latest/pyserial_api.html)区分读超时和串口异常；简单放宽位置校验不能补回没有收到的数据。

1. 软件保持单一串口访问、按轴核对反馈、有限只读重试及停止状态恢复。无反馈时停止继续下发，不用“上次目标位置”冒充当前位置。保留当前 50 Hz 平滑规划和动态追踪。
2. 下次复现时先保留日志：两轴同时失联优先查共用链路；只一轴失联优先查该轴的连接/供电/ID。这个判断缩小排查范围，不是硬件结论。
3. 机械边界确认后，再对照静止查询与小幅运动查询。若运动时才失联，优先测运动瞬间供电并检查线缆拉扯；若静止也失联，再分别更换一条 USB 线或端口，其他条件保持一致。接线调整应断电进行。

行程保持：Yaw ID0＝1404–2500，中位1952，总1096；Pitch ID2＝1255–1855，中位1555，总600。软件数值不等于已确认的机械安全边界，该部分等你现场检查。

### 5 · 下一步与交接

双目参数已生效，你可以查看现有网页。先完成机械行程检查；随后用固定头姿态做身体两路的左/中/右语音测试，补足刻度—实际角度关系，再将四麦原型接入实时链路。现有两耳结果和视觉优先策略继续工作。R42 源码修复仍需在原终端正常重启后生效，本轮没有重启服务。

证据分层：双目＝真实采样验证；串口＝真实只读反馈；四麦关联＝离线软件原型；多人声源、近场四麦融合、机械边界、正式测距＝待现场验收。

2026-10-28 / R42 SOFTWARE REVIEW

### 全链路复核：修复配置切换与旧双麦分支问题

当前运行 R41，自动转动已暂停；R42源码已验证，待正常重启加载。本轮没有舵机动作、新录音或主服务重启。

676项Python回归 / 66项前端检查通过。新增26项检查在冻结旧版中3项通过；修复后26项全通过。旧测试的一处原装配中位硬编码已改为校验当前保存的有效范围。测试通过不等于现场方位精度或机械端点验收。

项目 | 复现的问题与影响 | 修复与验证
R42-01 高优先级 | 改变方向、音频通道或控制策略后，旧目标和旧反馈状态可能继续使用。 新设置与已经排队的动作不在同一套坐标或策略下，重新建控制器也可能沿用计划位置。 | 统一撤销旧动作、清空核心方向及搜索/追踪上下文；相关设置改变后暂停，下一次启动重新同步真实位置。 源码已修复 · 离线验证 TransitionTests：direction / control / array replacement / mapping / direct servo config
R42-02 高优先级 | 关闭跟踪功能只改变开关，后台已经发出的平滑轨迹未立即取消。 界面已关闭功能，头部仍可能继续执行上一条轨迹。 | 功能实际切换时撤销旧轨迹；切到另一种有效模式保留原来的运行意图，全部关闭则停止。相同开关重复保存不中断轨迹。 源码已修复 · 离线验证 TransitionTests：disable all / mode switch / unchanged mode
R42-03 高优先级 | 配置读坏时静默使用默认中位；直接覆盖文件时中断可能留下半份JSON。 已确认的1952/1555可能在下次启动时被旧默认值替代。 | 坏文件明确报错，拒绝静默回退；同目录写完整临时文件后替换，写入失败保留旧文件并暂停动作。 源码已修复 · 离线验证 PersistenceTests：truncation / root type / failed flush / failed replacement；TransitionTests：save failure
R42-04 高优先级 | 越界、反向行程及范围外中位可能被静默修正；同一舵机ID可被分配给两轴。 界面输入与实际保存范围不同，或者两轴命令指向同一硬件。 | 接口和配置文件均校验500–2500、下限<中位<上限及不同轴ID，不接受非法配置；新装配行程精确往返保存。 源码已修复 · 离线验证 ConfigValidationTests 六项；PersistenceTests invalid range / duplicate IDs
R42-05 中优先级 | 四麦后端关闭VAD时仍可能再经过旧双麦重分类。 真实PCM时序、方向不确定性等信息丢失，甚至给不可靠方向补出置信度。 | WASAPI四麦保留自己的检测结果、质量门槛和采集时间；旧双麦分支只用于旧后端。默认VAD开启路径保持。 源码已修复 · 离线验证 FourChannelEvidenceTests 两项：原证据保持 / unknown不补置信度
R42-06 中优先级 | 保存录音设置时，即使VAD开关没变也重新创建人声检测器。 正在累计的人声和方向证据被无必要地中断，短时看起来像听不到。 | 只在VAD开关真的改变时重建；仅改录音设置保持人声检测连续。 源码已修复 · 离线验证 TransitionTests：recording toggle / real VAD change
R42-07 中优先级 | 网页先提示声道保存成功，再保存人声参数；后一步失败或配置导致暂停时提示不清晰。 操作者可能误以为设置全部成功、自动控制仍在运行。 | 整个声音保存操作统一反馈；失败明确显示失败，保存后暂停明确提示“开始运行”；无效输入显示可读原因。 源码已修复 · 离线验证 test_settings_feedback.js 五项；R42运行版本显示检查

最终参数保持：Yaw 1404 / 1952 / 2500（±548）；Pitch 1255 / 1555 / 1855（±300）。50Hz平滑轨迹、速度/加速度、相机配置、声学频段与两耳间距未更改。核心方向保留、视觉优先和声音结束后1秒显示规则继续有效。

#### 仍需处理，未宣称已经解决

内容 | 当前结论 | 所需证据或下一步
身体两麦的四路融合 | 尚未启用，不应直接套静态四麦阵列 | CH1身体左、CH4身体右已确认；身体固定而耳朵随头转。需要头身相对几何、旋转轴及姿态转换，之后再做四路录音对照。两耳算法继续可用。
最终装配后的双目对齐 | 已有资料显示轻度残差，不能当作正式测距通过 | 最终安装固定后补标定板复核；现有装配检查垂直残差中位约4.6–4.8px、P95约7.3–7.7px。水平视差本身是正常双目现象，不应强行消除。
声源角度准确性与多说话人 | 时间连续性已有软件保护，现场精度尚不能保证 | 需要已知左右方位、多个说话人及实际运动噪声验证；现有目测位置不是精确角度真值。声音强弱或人脸大小不能当米数。
偶发舵机无反馈 | 错误处理和日志有覆盖，间歇故障根因未全部确认 | 再次出现时结合串口原始收发、供电和实际反馈定位。软件不会用目标值假装反馈，也不会绕过无反馈或异常模式保护。
新行程的机械边界 | 配置已保存、逻辑限幅已验证；本轮未做实物端点动作 | Yaw1404–2500 / Pitch1255–1855符合用户最后选择。结构干涉、线材余量和端点实物状态仍需在场确认。

#### 加载与检查

在原PowerShell窗口按 Ctrl+C 正常退出旧服务，重新运行原来的 run_server.py，然后对控制页按 Ctrl+F5。页面应显示R42，初始保持暂停。保存方向、范围或感知/控制参数后暂停是明确的配置切换行为；界面会提示重新开始。切换听声/视觉开关仍可保留当前运行意图，但取消旧模式轨迹。

验证边界：本轮是源代码、模拟接口、失败注入与已有回归验证；没有新物理测试，没有重新宣称真实左右角度、远距离、测距或实物顺滑度通过。

最终对称行程 · 已保存生效

### Yaw上限2500，以1952为中心左右各548。

操作者最终选择“以2500为极限，左右对称”。因此原先左右总行程1400的要求被本次选择替代：现在总行程是1096刻度，不再等待2652的设备支持确认。

轴 | 下限 | 中位 | 上限 | 单侧／总行程
左右 ID0 | 1404 | 1952 | 2500 | 左右各548／总1096
俯仰 ID2 | 1255 | 1555 | 1855 | 上下各300／总600

已通过现有程序的限位配置接口应用并读回，保存文件一致；左右预设同步为2500／2226／1952／1678／1404，俯仰均用新中位1555。网页刷新后读取新配置，无需重启程序。

本轮没有改变控制算法、速度或平滑参数，没有转动舵机、启用力矩、改写模式或扫描机械端点。自动转动保持暂停；这里确认的是软件配置，未声称机械端点已经实测验收。前面关于2652的计划及原端点只保留为历史记录。

历史方案：总1400与2652端点，已被上方最终设置替代

新中位两侧对称行程 · 最新配置说明

### 俯仰已对称设置；左右上端需要确认舵机指令范围。

操作者明确要求把实测Yaw1952、Pitch1555作为区间中点，而不仅是回中位置。因此目标是左右各700、上下各300刻度。上一节最终装配记录保留当时端点状态；本节为之后的范围调整。

轴 | 要求的对称范围 | 中位 | 总行程 | 当前状态
Yaw ID0 | 1252–2652 | 1952 | 1400 | 待设备范围确认，未提交；当前仍800–2200
Pitch ID2 | 1255–1855 | 1555 | 600 | 已通过现有配置接口保存并读回

当前配置归一化、网页输入和单轴诊断均以500–2500为位置范围。若直接把Yaw1252–2652交给当前代码，2652会被截成2500，实际只剩1248刻度；本次只在离线构造器中复现，没有把这个缩水范围保存到设备控制配置。

找到的杭州众灵科技舵机手册（第三方镜像） (https://www.renrendoc.com/paper/99607126.html)也列出该系列500–2500的位置控制值，但目前仅记录了实物固件版本，尚未确认完整型号和2652支持情况，不能由四位数串口编码推断可用范围。等待具体型号／厂家确认；如果2500确实为上限，就需调整舵盘或底座安装中位，才能在合法指令范围内得到左右各700刻度。没有用换算比例伪装成1400个实际舵机刻度。

仅应用俯仰配置。没有放宽通用位置保护，没有写硬件零点／模式，没有执行端点扫动或其他转动，自动控制保持暂停。初始值1952／1555与四麦映射保持。

最终装配记录 · 2026.10.28 · R41已加载

### 保存新装配的正前方基准，确认胸前两支麦克风。

身体和底座已固定，按操作者确认的当前实物姿态读取位置。当前主程序已正常加载R41，自动转头暂停。没有把网页上方的目标值1962／1563当作实测位置。

轴 | 软件下限 | 新初始／回中值 | 软件上限 | 总行程
左右 ID0 | 800 | 1952 | 2200 | 1400刻度
俯仰 ID2 | 1200 | 1555 | 1800 | 600刻度

三次新鲜位置反馈：Yaw 1952／1952／1952，Pitch 1555／1555／1554，采用中位数并保存到本机配置。原端点保持，新正前方不在行程几何中点：左248、右1152；抬头245、低头355刻度。以上均为舵机位置刻度，未换算成真实角度或重新验收机械端点。开机仍先读取反馈，不自动跳到保存值；“回中”使用这组新值。

操作者提供：头部、身体及底座最终装配照片。

以本轮文字测量值13.55／7.55／17.7–17.8 cm记录；图上标注为近似值。

USB声道 | 实际位置（小熊自身左右） | 确认依据 | 当前用途
CH1 | 身体左 | 第二组熊左摩擦，CH1较CH4中位强约8.0 dB | 完整采集、通道已确认；暂不驱动定位
CH2 | 左耳 | 保留此前逐耳确认 | 两耳方向定位
CH3 | 右耳 | 保留此前逐耳确认 | 两耳方向定位
CH4 | 身体右 | 第一组熊右摩擦，CH4较CH1中位强约9.6 dB | 完整采集、通道已确认；暂不驱动定位

4通道、48 kHz、16 bit WASAPI RAW本机实录，0录制丢块。该测试确认通道身份，不能作为准确声源角度或四麦融合验收。

布局数据已保存：两耳约13.55 cm；身体两麦约7.55 cm；图示耳身一对约17.7–17.8 cm。耳部随头动，身体麦固定，跨头身的距离与朝向随俯仰和转头改变。这些长度不能唯一确定完整三维坐标与旋转轴，因此没有把它们当作固定矩形阵列直接启用。下一阶段先评估身体双麦方向，再验证与头部姿态相关的融合；精确声学距离与正式双目米制距离继续关闭。

本次新装配后的双目只读自检为“轻微残差”：垂直中位4.60–4.82 px，P95 7.31–7.66 px，允许继续二维跟踪；不沿用前一场景的1–3 px结果宣称当前姿态也已通过。后续需在最终固定状态拿板复核。当前源代码、平滑规划、速度、加速度、限位端点、两耳算法与音视频采集规格未修改。本轮仅保存配置和识别录音，没有转动舵机、启用力矩、模式写入或代重启主服务。间歇性位置反馈问题仍未宣称完全排除。

R41 · 双目对齐与控制代码复核 · 2026.10.28

### 对齐数据已经加载，新增控制保护待正常重启。

当前服务实查为R40、自动动作暂停。新相对姿态参数已通过现有摄像头配置入口加载，不涉及主服务重启。R41新增源码通过650项严格回归、60项前端检查，需正常重启后加载。以下历史版本段落保留各自验证时的运行状态；最新状态以本节为准。

验证材料 | 校正前 | 校正后
11帧未参与拟合的ChArUco共同角点 | 各帧垂直误差P95约6.4–7.1 px | 约0.6–1.6 px
另留出的背景特征 | 校正前仍有上下残差 | 合并P95约2.0 px
拟合后重新抓取的8帧 | 各帧P95约3.7–10.8 px | 约1.1–2.9 px，8帧均改善
共同有效矩形 | 1836×1050 | 1874×1053，保留约95.2%传感器像素面积

共保存346帧原始3840×1080双目同帧JPEG，逐帧从后向前检查；11帧检出至少12个共同角点，最多23个。角点帧属于一段短时间姿态分组，不能当作11个独立标定姿态。右眼仍偏虚，未声称软件修复了光学对焦。

上：原参数；下：更新相对姿态。蓝线仅为高度参考。左右水平位置差异属于视差，不把两幅图强行贴成同一视角。

方法：固定已有内参与畸变，使用可靠共同特征的对极约束，以Soft-L1估计两眼相对姿态修正，旋转改变量约1.29°；保留名义基线长度。重新计算立体校正映射与共同有效裁切，检测框、方向投影和预览共用这一坐标系。一般立体校正的目的与投影关系可参见OpenCV官方说明 (https://docs.opencv.org/4.13.0/d9/d0c/group__calib3d.html)；本轮效果与数值以本地保存的验证材料为证。

复核发现 | 修复 | 验证范围
原启动自检阈值偏宽，仍有可见残差也显示通过 | SIFT共同特征、覆盖范围检查；区分正常／轻微残差／明显偏移。轻微残差不阻止二维跟踪。 | 8组真实画面回放及平移、局部纹理、遮挡等反例
诊断接口arm=false绕过位置与模式检查 | 先停止旧动作，读取有效范围内的位置和模式；核对同一串口会话，停止后到达的旧请求不能下发。 | 假串口测试，无反馈、越界、错误模式与停止竞争均拒绝位置写入
arm=true在校验后还会重复启用一次力矩 | 启用一次，检查启用后的反馈再写目标；不自动改写模式。 | 假串口字节序列与启用后跳动反例
更换摄像头可能保留旧目标动作和旧自检结果 | 更换前取消动作，清空旧自检状态，下次开始重新检查。 | 模拟API时序与取消测试
校正文件可接受反射矩阵或不规范内参 | 要求正规旋转和可用的相机矩阵；拒绝非法输入。 | 矩阵反例测试
页面容易把“已加载校正”理解为目标已经两眼共同计算 | 明确显示当前目标有无可靠双目纹理对应，并解释正常左右视差。 | 脚本语法和显示检查

新增17项针对性测试在冻结R40源码上仅3项满足新要求，修复后17项全部通过；完整650项测试无失败、异常或跳过。原平滑规划、舵机行程和参数、听觉DSP与核心声源决策源码哈希保持。

边界：本轮未发送舵机动作、启用力矩、模式写入或新增音频录制；定时任务保持暂停。正式米制距离继续关闭，纸面平整度和尺寸没有新增验收。曾经出现的串口零字节反馈故障仍未证明完全解决，机械顺滑度和真人声视跟随需现场确认。听声不转这一截图已由操作者确认与排查暂停有关，本轮没有据此更改听声策略。

R40 · 真实模式回包兼容修正

### 硬件已返回模式1，程序不应把它误判为unknown。

R39新增模式读取只识别 #000PMOD1!，但当前舵机实际回复 #000MOD1!。串口日志记录了20次这个有效回复，旧解析均拒绝，从而挡住回中或首次动作。这是本次新增的兼容性缺陷，不能将其归因于供电或没有响应。

内容 | 修正与验证
解析 | 兼容MOD与PMOD两种完整回包，仍需匹配所查询的ID和结束符。读取命令仍是PMOD，不发送设置模式命令。
保护保持 | 仍必须确认模式1；错误ID、截断帧、查询回显、未知模式和模式5不会被当作可用模式。位置反馈、范围和启用跳动检查保持。
证据 | 20条原始日志逐条回放，旧版接受0条，新版接受20条。新增8项反例测试，完整633项回归及57项前端检查通过。
范围 | 没有改动听声决策、视觉或平滑运动算法。当前服务已实查加载R39且暂停；R40需正常重启。本轮无实体动作、力矩／模式写入或新增音频录制。

这是已确认的软件解析错误修复。此前“位置查询没有返回任何字节”的间歇故障是另一类现象，不能据此宣称也已解决；R40的实物动作仍需加载后检查。

R39 · 初始化与自动识别／启动双目检查／首次声源响应 · 软件验证完成

### 先消除不必要的初始化写入，保留连续轨迹，并让第一个可靠声音更快获得响应。

本轮由现场反馈驱动：点击开始或方向键后曾出现俯仰下砸，ID0又反复没有反馈。原R38服务的日志确认过“两个ID都无回包”“ID2回包878越出1200–1800范围”“ID0单独无回包而ID2正常”三种状态。设备管理器与网页配置均为CH340 / COM3，麦克风串口为COM5。因此不能把问题归结为网页填错串口，也不能仅凭一次恢复就称为修好。

项目 | R39已实现 | 验证与边界
首次启用 | 普通动作不再自动发送PMOD1改写工作模式。先读位置、只读确认模式1，再恢复力矩，重新读取位置；启用时无反馈、越界或变化超过12刻度，均不发送新位置目标。第一次只有左右目标时，不同时启用俯仰轴。 | 删除的是初始化副作用，不是停止保护。已验证各种异常反例；尚不能证明模式写入就是那次下砸的唯一原因。真实模式回读与初始化仍需加载后复测。
平滑控制 | 保留50Hz、T40ms位置流、五次多项式轨迹及原速度／加速度／jerk／行程。启用检查放在新轴准备阶段，已验证的稳态位置流不会逐帧重复查询或使能。 | 16组轨迹与R38逐点完全一致，规划器语法树也一致。首次轴启用涉及真实反馈等待；本轮没有新增实物运动，不宣称机械顺滑度重新验收。
三类设备自动识别 | 摄像头继续按1BCF:0B15寻找USB路径；四麦继续按EF09:459D和WASAPI四路输入寻找，补上拔插后旧流查询／关闭抛异常的恢复。舵机串口新增只读搜索，以配置的两个ID回包确认；排除麦克风COM口，保存已确认的新COM号。旧端口消失后，开始／手动同步前会重新搜索。 | 不会仅凭“第一个COM口”就启用。多个匹配控制器时保留人工选择；单轴无回包会明确列出，不能伪装成成功。网页增加设备刷新和串口搜索按钮，实际端口来自后台。
开始前检查双目 | 每次开始读取最多3个新鲜双目样本，检查现有校正后的共同特征垂直偏差。明确偏移会阻止视觉自动启动；纹理不足显示无法确认。独立听声不因双目几何失败被挡住。另提供只读检查按钮。 | 只检测健康状态，不改写标定、不开启正式深度。来自同一USB拼接帧不等于已经验证硬件曝光同步。左右人脸中心的水平差可以是正常视差，不能强行当作“不同步”消除。
当前预览诊断 | 读取现有服务的3对960×549预览：共同特征垂直误差中位数3.60、4.32、3.73px，p90为6.0–7.5px；未发现明显对齐失效。 | 这是现有预览的只读数值检查，不是正式重新标定、硬件同步或米制精度验收。镜头安装若确实变动，仍应重新采集标定图。
首次声音与多人竞争分开 | 只有一个可靠候选时，首次锁定允许至少0.10秒有效证据、3次新观察、0.035质量加权秒及足够平均质量；不必先击败不存在的声源。旧方向至少安静1秒后，同样允许新可靠方向更快接管。仍有活跃竞争者时沿用原切换迟滞。 | 单个大声包、重复或乱序数据不能触发。弱第三方向不能走快速通道。保留原人声和时差可信度门槛；不是有能量就一定转头，也未训练新网络。
响应时间对照 | 12组已知方向输入：20／50／100ms更新间隔下，旧决策首次锁定为0.24／0.30／0.40秒，新版为0.10／0.15／0.30秒。 | 从“可靠方向送达决策层”起计，不是从人开始讲话起计；尚未证明现场开口到转动的总延迟。
验证与加载 | 625项完整回归零失败／错误／跳过，新增31项；57项前端检查通过。既有97.1秒RAW的4855窗口重新回放，341个合格原始方向保持，估计未被修改。 | 当前8010仍为R38、自动转动暂停。R39待正常重启；本轮没有代重启、实体运动、使能／模式写入或新增音频录制。定时任务保持关闭。

仍需确认：ID0间歇丢回包的物理原因，模式查询是否由当前型号正确响应，俯仰首次启用、USB重新分配、真实单人响应和多人换人。供电、共地、信号线、接头与舵机本体都尚不能排除。新版不会靠忽略反馈、扩宽俯仰范围或伪造当前位置来恢复动作。

R38 · 实际演示流程审查 · 软件验证完成／待正常重启

### 保留声音位置，同时明确这一刻由谁控制头部。

本次按“多人交替讲话、短暂断声、边转边听、视觉丢失、声画冲突、输入重置与停止再启动”复核整条链路。复现并修复6处决策边界。当前8010服务实查已加载R37且自动动作暂停；R38源码已验证，尚未代重启或执行实体动作。旧版本各段记载的是当时状态，下面为当前结论。

编号 | 旧逻辑的实际问题 | R38处理
R38-01 P1 | 视觉接管后丢脸，旧声音记忆可能重新驱动，转回旧位置 | 分开位置记忆和动作意图。视觉接管撤销听声动作；失去视觉后需新的合格核心声音重新授权。进行中的已授权转头不因unknown取消。
R38-02 P1 | 两个功能同时开启，画面不可用时把独立听声一并挡住 | 无可见或保留视觉目标时，可完成可靠的有限听声转向；保留视觉锁时继续等待新画面，不用旧画面控制。
R38-03 P1 | 说话人停顿，被更大但未讲话的人脸替换，容易来回切人 | 保留已经声音确认且仍可见的人。新确认说话人、真正丢脸或关闭声音辅助才允许相应换人。纯视觉初始仍选大而可靠的人脸。
R38-04 P1 | 候选方向缺席时，别处的新声音也可能累计它的切换确认 | 只让挑战方向自己的新有效观察推进持续确认。重复、unknown、其他方向不加票。
R38-05 P2 | 短而强、尚不满足时长的方向挡住已经合格的持续声音 | 先按有效时长、质量、观察数筛选合格候选，再比较其证据分；未降低原阈值。
R38-06 P1 | 更换音频输入或动作坐标配置后，旧声音位置可能仍被沿用 | 输入流、头部控制实例、通道/间距/映射、控制增益或模式改变后失效旧记忆和动作意图。

#### 整条链路的决策顺序

1. 四路RAW采集，仅以左耳CH2／右耳CH3计算两耳时差；先检查人声、频段可靠性和方向稳定性。
2. 可靠的新方向按有效时长、质量与近期程度累计核心方向分。分值衡量方向证据，不代表身份或语义重要性。
3. 两眼分别检测并关联可见人。声音与整张脸的角度区间匹配，综合方向、相对大小、检测质量和连续性；大小不换算成声音距离。
4. 有可见视觉目标时以其新鲜视觉位置闭环跟随。已确认说话人停顿仍保留；更强且持续的声音对应另一张可见脸时才换人。
5. 没有可见或暂存视觉目标时，已确认声音可发出一个有限转向目标。声音随后变unknown，已经有效的动作继续完成，旧相对角度不会反复叠加。
6. 视觉接管、停止、输入或坐标配置改变会撤销旧动作。保留的位置记忆本身不能在后续丢脸时重新驱动，必须有新的合格声音证据。
7. 沿用舵机反馈、行程限制与连续轨迹。蓝色实时范围结束后仅保留1秒；金色是位置记忆估计，页面另列动作归属。

验证层级 | 本次结果 | 能说明什么
严格软件回归 | 594项通过，零失败／错误／跳过；新增21项。41项既有声音显示、6项核心标记和5项动作归属显示检查通过。 | 覆盖停止、反馈故障、丢帧、重复／乱序、静音、噪声、摩擦、纯音以及模式切换的相关回归。6个开发复现问题全部修正。
独立模拟 | 55组不同方向、画面失效条件、停顿时长和输入切换；原R37为14组满足预期，R38为55组。 | 证明指定切换逻辑，人物、时间和电机均为模拟，不是实验室成功率。
已有真实录音 | 97.1秒RAW、4855窗口重新回放；341个合格原始方向保持，未修改原始声音估计。 | 接收时钟与固定头位为合成；不是新增现场声音或真实转头验收。
本轮实体状态 | 只读确认R37已加载、自动动作暂停。无新录音、舵机实物动作或代停／重启；定时任务保持关闭。 | R38需用户在原终端正常重启后才用于现场演示。

#### 适合怎样演示，以及还有哪些边界

场景 | 当前预期 | 待确认或不能承诺的内容
单人视觉跟随 | 没有声音时选较大、可靠的人脸，之后稳定跟随；左右和上下沿用原闭环。 | 本轮未改视觉检测、双目几何、视觉运动算法或舵机底层。真实跟随效果由现场检查。
单人听声转头 | 关闭视觉跟踪、保留相机预览，讲话1–2秒较便于演示。持续证据确认后朝声音方向转动，停顿不会取消这次有限目标。 | 首次证据至少0.24秒，还要经过人声与方向确认；不是一个极短音节必然触发。角度—舵机增益未实测标定，短句后可能留有残差。
两人轮流讲话 | 同时开启两个功能；不同水平位置轮流正常讲话，较强、持续且对应可见人脸的新方向可以换人；原说话人停顿不跳到沉默大脸。 | 实际多人切换、转动自噪声和小熊右侧角度压缩仍需现场配对验证，不能用这些模拟证明物理精度。
声画冲突或画面暂不可用 | 可靠可见视觉目标优先；无可见／保留目标时声音可独立转向。只读的旧画面不用于新视觉动作。 | 双模态下，画外声音不会任意抢走仍可见的视觉目标，这是保留的视觉优先规则。
同角度不同远近的人 | 以人脸相对大小作为接近程度参考，叠加质量与连续性。 | 双耳不能可靠测量声音距离；不能保证从同一方位的多人中准确认出谁讲话。正式双目米制测距仍关闭。
多人同时讲话、背后声音、远处轻声 | 质量不足时维持已有目标或视觉，不强行给出新声源。 | 当前不是多源语音分离系统；两耳有前后歧义。远距离、安静人声和真实电机噪声需要独立录音与现场对照。

现场验收顺序：先确认页面版本R38 → 单独听声、说完后是否继续完成有限转向 → 单独视觉上下左右 → 两人轮流讲话与停顿 → 遮挡／离开再返回 → 停止后不动作。每项以日志和实际观察核对；此清单尚未执行，不代表现场已通过。核心方向位置沿用既有控制增益估计，不是标定坐标。

R37 · 时间证据评分 + 核心目标锁定 · 软件验证完成

### 短暂 unknown 不再丢掉已经确认的转向位置。

用户反馈舵机控制效果还不错，本轮集中修正听声决策。旧版在只开听声时，预览里的嘴部候选、视角切换或过期画面仍会拦住动作；下一步听声搜索也依赖当前方向，短暂断声后无法持续对准。新版将实时声学测量、核心声源记忆和有限舵机目标分开，原始麦克风算法与舵机底层保持。

规则 | 当前实现 | 验证与边界
如何量化“核心” | 最近2.5秒按有效讲话时长累计证据，1.5秒近期衰减；每次权重综合人声概率、时差可信度、时间稳定性和角度不确定度。重复快照不加票，音量大不直接加优先级。 | 按持续时间计分，避免回调更快就得分更高；分数是方向证据分，不是说话人身份或语义重要性概率。
首次锁定 | 至少0.24秒有效语音、3份新观察及足够累计质量，才生成一个有界的舵机目标位置。 | 单次大声、低可信方向、乱序和重复数据不能直接锁定。
何时切换方向 | 挑战方向至少累计0.4秒有效语音；分数超过当前方向的1.25倍并多出固定裕量，再连续确认0.25秒及3份新观察。 | 短促杂项或两个方向分数接近时保留原目标；不是每帧挑一次最大值。
声音突然消失 | 保存具体目标位置，unknown不清除、不重新累加旧相对角度；当前轨迹继续到已确认的位置。手动停止、启动代次、配置或控制模式改变仍可清除动作意图。 | 在36组虚拟场景中，确认后的目标全部跨断声保留；已确认的视觉目标继续优先。
头部转动后的坐标 | 用声音采样时刻附近的估计头部位置，将局部声音角度换成动作参考位置；新鲜声音可持续修正目标。 | 采用现有控制增益，尚无实测“角度—舵机位置”标定。短句结束后可能保留角度残差，不能宣称一次就精确对准0°。
网页显示 | 淡蓝色仍表示实时声音范围并在结束后保留1秒；金色虚线单独表示锁定目标的估计位置，断声仍保留。页面列出主要方向的证据分和有效语音时长。 | 金色记忆不会伪装成新的人声观察；视听选人只收到当前属于核心方向的新鲜声音。
软件与已有录音 | 573项完整回归零失败／错误／跳过，新增18项；41项既有显示检查和6项核心标记检查通过。36组虚拟场景正确转向12 → 36。 | 97.1秒RAW录音4855个窗口回放，341个合格原始方向保持、原估计未被修改。回放使用合成接收时钟与固定头位，不是新的实物转向验收。
加载状态 | 源码R37已完成验证；当前用户运行的服务仍报告R36，需在原终端正常退出并重启后加载。 | 本轮没有代停／重启、新录音、舵机实物动作或恢复定时任务。

参考 ODAS官方定位与跟踪配置 (https://github.com/introlab/odas/wiki/configuration)中将定位与时间跟踪分开的结构，本轮采用自己的轻量时间积分与迟滞规则，未引入ODAS滤波器或新训练网络。真实小熊右侧压缩、多人场景切换与机械角度标定仍待现场确认。

2026.10.28 上午交接准备 · 10点核验快照

### 已验证源码 R36；当前服务仍是暂停的 R32。

本轮整理听觉与视听融合的实际成果，核对启动入口，保留稳定视觉。还没有替操作人员重新启动程序；11点最终只读核验和暂停定时任务尚待执行。下表把源码实现、离线验证、历史录音和待现场确认分开。

版本／项目 | 已完成与证据 | 真实运行与待确认
R33 运动期间听觉 | 可靠声音按声学质量继续判定，测量与电机下发节奏分离；新PCM允许有限多步搜索，旧缓存和超时不重置搜索预算。521项回归及41＋6项显示检查通过。 | 历史录音加运动标记属于反事实回放，不能当真实电机噪声验收。源码等待正常重启。
R34 频段冲突保护 | 两个独立合格的中高频时差一致却反驳全频段时，保守拒绝方向。已知时差独立子集错误20 → 16；5份历史录音37890个窗口的估计逐项保持。 | 仍有16个受控错误。实物小熊右侧方向压缩原因未确认，没有拉伸角度。
R35／R36 声画关联 | 长断档后重新确认；声音与画面各自检查新鲜度。提前换人48 → 0、异常时序接纳60 → 0，正常360／1080帧分别保持。当前完整回归555项通过。 | 350ms声画关联预算仍需现场观察；原声音显示、相机和视觉控制节奏保持。
未采用的听觉候选 | 全白化方案降低真实录音可用输出；联合中高频方案在180个独立正确输入中误拒26个。两者都没有进入主程序。 | 没有新增训练网络，没有把梅尔谱图相似度当定位，也没有伪造声学距离。
本轮交付核验 | 95个源码／网页／测试／配置文件保持；核对上一版1002份证据哈希。6个启动组合通过隔离模拟，18项审计检查通过，启动命令经PowerShell语法解析。 | 没有构造真实应用、启动第二服务、打开设备、录新音或发舵机动作。555项生产回归按完全相同源码哈希沿用，未冒充本轮重跑。
入口说明修正 | README的旧目录 [本机用户目录已隐藏]\v1zhang\positioning_robots 已更正为当前桌面工程，首页版本与交接入口更新。 | 运行中的R32不会因文档或磁盘源码更新而自动变为R36。

#### 正常加载 R36

在旧服务原来的PowerShell窗口按Ctrl+C，看到退出完成后再运行下面四行。随后对控制网页按Ctrl+F5；只读查看 http://127.0.0.1:8010/api/state 应报告 algorithm_revision: R36、running: false。这些命令本轮只做了模拟与语法检查，没有执行重启。

Set-Location "[本机用户目录已隐藏]\Desktop\DeepSight-3D\positioning_robots"
$env:LOCATOR_DEMO_PORT = "8010"
$env:LOCATOR_DEMO_SIM = "0"
& "[本机用户目录已隐藏]\miniconda3\envs\demo\python.exe" -X utf8 .\run_server.py

下一步先在新版核对两耳电平、人声、方向显示和串口只读反馈，再开展有人在场的有限实物复测。右侧角度压缩、真实电机自噪声、轻声与远距离、多说话人切换、实物顺滑度仍未验收。当前两耳无法可靠测声音距离，正式双目米制距离也未通过。左CH2／右CH3、身体CH1／CH4排除、四路48kHz／16bit RAW、13.55cm估计间距与零点0保持。

09:00 研究复核 · 候选未采用 · 源码保持 R36

### 联合频段可以减少一类误判，但会漏掉另一类正确方向。

继续检查相关低频干扰把方向拉向中间的模拟问题。实验候选让中高频共同提出一个时差，再检查两段的相位是否一致；它只能否决既有输出，不能替换角度。独立反例发现正确方向会被误拒，因此没有把候选写入主程序。

材料与验证范围 | 结果 | 判断
开发集：56个已知时差合成输入 | 错误时差8 → 0，未丢失原正确输出。 | 只用于开发，不能作为采用依据。
首批独立验证：534个输入，含增益、极性、回声、竞争声源、纯音等 | 错误时差28 → 6，没有新增接纳；但其中“低频目标／高频干扰”组原本就没有正确输出。 | 该组“未丢失正确结果”缺少有效样本，不能算保留能力通过。
补充独立反例：180个宽带目标，改变高频强弱并叠加较弱高频干扰 | R36原有180个正确时差，实验候选误拒26个；种子、波形摘要、时差与门控结果均已保存。 | 违反预先规定的零正确结果损失要求，拒绝采用。
已有真实录音回放：97.1秒、4路48 kHz／16 bit RAW | 4855个处理窗口，方向接纳341 → 341，逐项估计无变化；正常讲话段339 → 339。 | 只说明这份历史录音保持，不能覆盖上面的合成反例或代表实物角度真值。
候选进程内覆盖检查 | 555项现有回归通过；两处时差工厂明确替换为实验类，主程序文件和服务未改。 | 现有回归通过仍不足以采用，新增独立反例已经否决候选。
保留版本与当前运行 | 95个源码、网页、测试及配置文件与本轮冻结基线逐字节一致；R36已验证的555项结果保留。现有8010仍报告R32，自动动作暂停。 | 没有发布R37，没有新录音、实体舵机动作或代重启。

例：已知时差 −10.923 采样，R36输出 −10.289 采样，候选却判为不可用；这是人工合成时差，不是实物角度精度。较高频段也可能由干扰占主导，不能简单认为“高频一致就一定是说话人”。R34原独立子集的16/20个问题仍保留，不能用候选的6个剩余问题替换当前版本的状态。真实小熊右侧方向压缩、电机自噪声和远距离声音仍待确认。

方法参考：Pyroomacoustics 官方 DOA 文档 (https://pyroomacoustics.readthedocs.io/en/stable/pyroomacoustics.doa.doa.html)允许按频段选择参与定位的频点；本轮的取舍由独立实验决定，文档不证明这个频段候选适用于当前人头。

R36 · 声画时间对齐 / 离线验证完成

### 当前声音不再与时间异常或过旧的画面配对。

补齐上一轮记录的两类时钟漏洞：画面时间落在未来，或者画面已经较旧、却因为它和声音之间的时间差不大而被误接纳。现在声画选人会检查各自的新鲜度；不合格时保留视觉规则，当前声音方向、雷达和蓝色渐变仍继续显示。

复现输入 | 当前时间20.0 s，画面却写成20.2 s；另一例声音19.7 s、画面19.3 s，二者只相差0.4 s，但画面已旧0.7 s。旧版都会允许声画关联，新版拒绝这两类输入。
独立验证 | 84个异常时序组合中，旧版错误接纳60个，新版接纳0个。84个健康时钟组合保持；8个边界检查和36组正常序列通过，正常1080帧决策与旧版逐项一致。上一轮的4个开发探针已关闭。
声音显示继续可用 | 新增2个绘制检查：即使声画配对被拒绝，可靠声音仍能画出雷达和左右眼渐变，角度不变。蓝色历史范围仍只保留1秒，不作为新控制证据。界面会说明“画面时间异常”或“画面更新稍慢”，不会把它写成麦克风失效。
采用的时间规则 | 仅声画关联沿用350 ms新鲜度预算，并保留20 ms时钟容差、原450 ms配对差检查及零值未指定时间的旧接口。没有修改相机采集参数、视觉有效期或视觉控制节奏。若实机长期处理超过350 ms，声音选人会暂缓，需现场观察是否过于频繁。
回归与保持 | 555项完整回归通过，新增11项；41项声音显示检查、2项新增绘制检查、232项实验检查通过。视觉检测、双目几何、视觉控制、听觉信号处理、耳位、间距、零点与舵机配置均保持。未增加“运动就禁声”的规则。
加载与边界 | 现有8010服务仍报告R32，自动动作暂停；R36源码待正常重启。本轮没有新录音、实物舵机动作或代重启。时钟检查属于人工输入模拟，不能据此宣称实物选人或声源角度准确率通过。

真实右侧角度压缩、电机自噪声和远处轻声仍待解决。R34的分频段保护与R35的长断档重新确认继续保留；本轮没有重新解码既有录音，信号处理源码和对应历史验证保持。

R35 · 视听觉连续性 / 离线验证完成

### 声音采集长断档后，从新的证据重新确认说话目标。

复现了一个选人时序问题：中断前已累积的声音确认次数会留到恢复后，首个新声音就可能与旧记录一起触发换人。现在按已有350 ms声音新鲜度预算处理，超过该观察间隔时重新从1次确认开始；保留当前视觉锁定，后续连续新证据仍能正常切换。

具体触发 | 先收到3次可靠声音，候选正在确认；之后处理停顿或观察断档1–5秒。旧版恢复后只收到1次新声音就可能沿用旧确认提前切换。新版恢复时只记1次，缓存重复读取不增加次数。
独立时序验证 | 48个预设验证组合中，提前切换48→0；后续持续新声音均能重新确认。另有4个开发场景、4个349/350 ms边界场景及12组正常序列。正常序列360帧的决策与旧版逐项一致。
运动中继续使用声音 | 判断依据是声音观察时钟的间断，不是舵机是否转动。持续小幅运动中的可靠声音仍可辅助选人；当前方向和1秒蓝色显示保留规则保持。序号跳号但观察间隔正常时也不会误判为长断档。
回归与保持 | 544项完整回归通过，新增10项；41项声音显示检查通过，128项实验检查通过。生产实现与冻结原型一致。视觉检测、双目几何、相机、视觉转向代码、听觉信号处理、舵机配置、耳位与零点均保持。本轮没有重复解码录音，沿用R34已归档的录音验证及未改变的信号处理源码。
加载状态 | 现有服务仍报告R32，自动动作暂停；R35源码待正常重启。没有新录音、实物舵机动作、代重启或另开硬件服务。
下一项已记录 | 另发现给定视频时间在未来，或声音与画面都较旧但相互时间差仍合格的边界输入；两种策略共4个探针尚待处理。本轮仅完成声音确认跨断档的修复，没有声称解决所有时钟问题。

这些结果来自固定人脸方位与声音质量下的人工时序模拟，反映确认状态机的行为，不是实物多人选人准确率。真实右侧角度压缩、电机自噪声和现场跟随效果仍待确认。

R34 · 分频段时差交叉核验 / 离线验证完成

### 可靠频段互相矛盾时，停止用错误的中心方向辅助选人。

新增250–1200、1200–2500、2500–5000 Hz的分频段时差检查。仅当中、高两段各自有足够证据、彼此一致，却与原全频结果明显冲突时，才把本次声音方向标为不确定，继续按视觉跟随。保留原有加权GCC、语音检测、时间确认和运动中可靠声音策略；没有替换角度、放大左右值或要求舵机停稳。

复现案例 | 强同相低频干扰把已知18.05采样时差的目标拉成全频1.21采样；分频段给出低频0.01、中频18.05、高频18.04。新版拒绝这个互相冲突的结果，保留视觉，不把任一频段的角度直接当成最终方位。
独立模拟验证 | 420个开发/验证案例与420次镜像检查；开发中的错误时差10→8，独立验证20→16，正确时差丢失0。这里的错误指与已知合成时差偏离超过2个采样，并非实物角度准确率。独立验证仍有16个错误未解决。
真实录音回放 | 5份完整四通道RAW录音、37,890个重叠分析窗口，与冻结R33的AudioEstimate逐项一致，合格方向丢失0。新版保护没有在这些录音中触发，因此尚不能证明现场右侧角度变准。原始录音、模型、CH2/CH3和时间顺序均保持。
回归与协同 | 534项完整回归通过，新增13项；41项声音显示检查通过。覆盖单一频段不足、镜像、反相、静音/纯音、身体通道排除、证据过期、运动时保留真实拒绝原因及声音不确定时继续视觉选人。实验采用门槛49项通过；生产实现与冻结实验420例决策完全一致。
处理成本 | 复用原有平均频谱，增加3次频段逆变换。5份回放中，本机定位函数的最高P95约3.91 ms；该数值不包含采集、VAD或网页，不代表实物端到端延迟。
保持与加载 | 视觉检测、双目几何、视觉控制、相机、舵机参数、左耳CH2/右耳CH3、13.55 cm工作间距与零点保持。现有8010服务仍报告R32、自动动作暂停；R34源码待正常重启。没有新录音、舵机动作、代重启或另开硬件服务。

验证边界：已实现的是一类可复现冲突的保护。真实右侧压缩成因、电机自噪声、远处轻声与多人实物效果仍待确认；两耳不能可靠输出声音距离。保护按声学证据执行，持续小幅转动不会一律禁声。历史蓝色范围仍只保留1秒，不用于新的控制。

依据：SciPy官方相干性定义与分段平均说明 (https://docs.scipy.org/doc/scipy/reference/generated/scipy.signal.coherence.html)。频段门槛和2/4采样的一致性判断是本次验证的工程规则，未作为角度误差标定。

2026.10.28 · 夜间听觉对照 / 保留 R33

### 先定位角度压缩的成因，再决定是否替换算法。

本轮已完成加权 GCC、两耳几何 SRP-PHAT 和完整白化候选的离线对照。候选在部分合成干扰中更好，但已存正常讲话的可用方向明显减少，因此没有安装。视觉、声道映射、13.55 cm 工作间距、零点和舵机配置均保持。现有服务仍为 R32 且自动转动暂停；R33 源码待正常重启。

模拟与数值检查 | 544 个主对照、40 个相关低频干扰压力案例、56 个非网格角度案例。504 个合成镜像与345个真实录音镜像检查均未发现固定单侧时差偏置；这些窗口存在重叠，不能当成849个独立实物实验。
为何没有直接换 SRP | 两耳、相同权重下，角度扫描与 GCC 对应同一互相关目标，数值一致性已检查。原始 SRP 峰还需要语音、模糊峰和输入健康门控；不能把每次扫描的最大值直接当可靠方向。
复现了什么 | 可控的同相低频干扰很强时，现算法在8个压力案例中4个输出被压到目标角度一半以内。完整白化在这组没有压缩，但真实录音有明显退化。这里只证明一种可能机制；没有确认实验室实际原因。
近场模型检查 | 按对称点咪头、直达球面波计算，40 / 50 cm 时使用远场公式的最大方位差约0.411° / 0.263°。未包含头壳、安装朝向或房间反射，不能代替实体标定。
神经网络取舍 | 理想纯时延可以只改变傅里叶相位；只比较梅尔幅度图不足以恢复方向。SALSA-Lite原论文 (https://arxiv.org/abs/2111.08192)保留跨通道相位特征，作者仓库 (https://github.com/thomeou/SALSA-Lite)说明示例特征按四通道输入计算。当前只有两只已安装耳麦，预训练权重的兼容性未验证，本轮没有新训练或安装模型。先前资料里将第三方复现称为作者实现的出处已在补充研究中更正。
回归与反例 | 35 项独立数值与来源检查、521 项完整回归、41 项声音显示检查通过。静音、独立噪声、纯音、超出物理边界的时差被拒绝；已存摩擦片段未作为人声方向。0 / −5 dB 的合成独立噪声条件仍大量拒绝，没有宣称低信噪比已解决。

#### 正常讲话回放：完整白化候选未通过采用门槛

录音 | 目测位置 | VAD窗口 | R33可用 | 候选可用 | 估计角度中位数
R18 正常前方（开发） | 大致前方 | 429 | 339 | 230 | -0.6° → 0.7°
R18 正常侧方（验证） | 小熊右侧 | 344 | 151 | 57 | -12.0° → -24.9°
R18 正常侧方（验证） | 小熊左侧 | 395 | 255 | 220 | 21.5° → 28.7°
R16 三方（验证） | 小熊右侧 | 103 | 51 | 57 | -44.5° → -45.6°
R16 三方（验证） | 大致前方 | 116 | 58 | 52 | -1.8° → -5.4°
R16 三方（验证） | 小熊左侧 | 123 | 59 | 57 | 11.6° → 39.7°
R16 前方（验证） | 大致前方 | 203 | 127 | 72 | -2.2° → -6.3°

同一完整四通道48 kHz / 16 bit RAW录音按20 ms节拍重放，只选CH2/CH3；窗口为重叠分析，数量反映可用性。位置为操作者目测，表内角度仅为算法输出，不能据此算准确率。前方339→230、验证右侧151→57的可用窗口下降，已足以否决直接替换。

尚未解决：真实右侧角度压缩、真实电机自噪声、远处轻声与多人实体切换仍待确认。本轮没有新录音、舵机动作或服务重启。下一轮先离线检查分频段相位与竞争峰的一致性，再决定有无可采用的改进；不会直接拉伸角度或降低旧门槛。

方案依据：Pyroomacoustics 官方 SRP 文档 (https://pyroomacoustics.readthedocs.io/en/stable/pyroomacoustics.doa.srp.html)、官方协方差与导向实现 (https://github.com/LCAV/pyroomacoustics/blob/master/pyroomacoustics/doa/srp.py)。本项目自行实现简化两耳对照，未下载执行外部程序。

R33 · 听觉与声视融合 / 视觉基线冻结

### 移动是背景信息，不能直接等同于“声音方向不可用”。

根据现场反馈，取消“只要舵机还在动，就把所有声音方向清空”的总开关。转动中通过既有语音概率、方向置信度、时间稳定性和不确定度检查的结果继续供蓝色范围显示及人脸匹配；声音未知、多峰或质量不足时保留真实原因。没有加入强制停稳的听声窗口，没有降低原有声学质量门槛。

完整协同链路 | 四路RAW保留 → 仅左耳CH2/右耳CH3做语音与时差分析 → 可靠方向同时送显示和候选评分 → 按方向区间、相对人脸大小、质量与连续性选择目标 → 视觉持续跟随。声音无效或无对应时保留视觉。音频测量和电机下发节奏独立。
人声存在但不显示方向 | VAD检出讲话不代表已得到唯一时差。多峰、弱方向置信度或过期输入仍不会画出新方向。蓝色历史范围只保留1秒，并明确注明“不触发转向”；它不会作为新的控制证据。
听声搜索过早停止 | 原先一步后角度变化不足6°就停止。现在新的有效PCM支持有限次继续逼近；重复旧数据不能重复驱动。保留搜索步数与行程边界，并修正超时自动清空步数导致反复搜索的问题。
左右偏差 | 操作者报告：小熊左侧较好，小熊右侧角度向中心压缩。此问题尚未标定解决；本轮没有拉伸角度、交换耳位、用人脸位置伪造声音角度，或把截图当角度真值。新增voice_direction_diagnostic数值日志，记录声音角度/时差、质量、候选区间、开关和选人原因，便于后续双侧对照。
视觉保持 | 视觉追踪代码块、相机与双目几何、视觉参数及原有动态追踪均与R32逐项比对保持。后续优化重点为听觉和声视融合。当前两耳不能可靠测量声音距离，远近只用可见人脸的相对大小辅助。

验证 | 旧版 | 新版
模拟持续转动80帧、同一可靠声音 | 可用方向0帧 | 可用方向80帧；真实选择器可切到声音方向中的可见人脸
已存正常讲话录音，反事实“运动中”标志 | 可用方向0窗口 | 通过原有检查的89窗口；角度修改0次
新PCM、每次角度变化不足6° | 1次搜索动作 | 3次有限动作（本组模拟为稳健档）
超时不能重置连续搜索预算 | 10次动作，超过本组3步预算 | 保持3步预算
软件检查 | 521项完整回归、41项声音显示契约、6项运动场景的方向图/双眼绘制检查通过；新增17项测试，1项旧测试从“一律禁声”更新为“可靠方向在运动中仍可用”，并增加低质量反例。

录音回放使用的是头部静止时已保存的完整录音，仅模拟运动标志，不代表真实舵机噪声鲁棒性已验收。没有新录音或新舵机动作。真实右侧角度压缩、精确方位、多人切换和实物效果仍待验证。

运行与加载：本轮已从现有服务读到R32版本；R32下方“待加载”说明保留当时历史。R33源码已通过验证，仍需正常重启加载，自动转动暂时停止，两项功能开关均已保留为开启。证据：hardware_inventory/av-listening-20261027。

夜间任务已安排：北京时间2026年10月27日21:00至28日11:00，每小时一次，共15个计划触发点；最后一轮只读核验和交接。重点为听觉和声视融合，视觉冻结。已有录音、已知时差与噪声反例可离线验证；用户授权在有效位置反馈与行程内做小幅实体数值检查，但无人现场的结果不能作为真人选人或声源角度准确率验收。首轮离线对照已完成，实验候选未采用；详见上方夜间对照记录。后续采用的改进以各轮证据为准。

R32 · 协同与动态追踪 / 源码通过离线验证，待正常重启加载

### 声音辅助找人，视觉连续跟随；大偏差大步追赶，接近中心减速。

旧版在同一组模拟用例中复现5个问题：中心画面仍把轨迹中间位置当作新目标；俯仰追踪会覆盖尚未完成的水平目标；仅听声时被预览中的人脸锁定阻止搜索；关闭声音后仍向选人提供声音；无效碎步使转动保护不断延长。修复后的同组6个协同用例全部通过，新增15项检查，全套504项严格回归与41项声音显示检查通过。

一起开启的含义 | 有可见目标时，视觉决定连续转向，可靠声音辅助选择人脸；声音无效仍保留视觉。没有可见人脸时可按声音搜索。两个开关同时开启不停止麦克风采集。运动中的噪声保护保留，停稳后恢复使用方向。
动态速度与步幅 | 同目标、同视角的新画面估计归一化图像速度，再换算为px/s显示。大偏差或持续向外移动时扩大步幅，接近中心时缩小步幅；请求动作时间由固定450ms变为约160–420ms。实际轨迹仍受速度、加速度、加加速度限制，可能耗时更长。
控制配置 | 左右单次修正上限由30提高为120刻度，并非每次都走120。最大速度180刻度/s、最大加速度600刻度/s²、加加速度3000刻度/s³和行程保持。停止区间保留已有目标，不再逐帧重发轨迹中间位置。
左右参考 | 根据操作者“声音图右侧、实际向左转”的反馈，将Yaw左向符号由−1改为+1，同时关闭原来的视觉横向翻转；两项成对修改保持视觉控制的原有符号关系，反转纯声音的Yaw方向。耳部左CH2、右CH3不变。真实方向仍待复测。
反例保护 | 换人、换眼、断帧、时间/序号回退及检测跳变重置图像速度；不以一次跳点判定快速移动。中心越过或滤波方向相反时不追旧误差。图像速度包含相机自身运动，不宣称是人的真实空间速度或距离。

#### 实录确认：麦克风收到讲话，断续方向仍需继续观察。

本轮录音在提示操作前启动，保存约159.74秒四通道48kHz/16bit RAW，其中操作者按要求正常讲话。原模型离线重放的两耳人声概率峰值约99.6%，162个20ms更新窗口达到0.5；同期运行服务峰值约98.7%，562次数值采样中有9次可用方向、4次时差歧义。采集无溢出、录音无丢块；没有依据此数据宣称人声漏检已全部解决或方向精度通过。第一次提示讲话早于数值记录启动，已明确排除。

#### 离线闭环对照：收益来自两种合成场景，实物表现尚待验证。

平均图像偏差（归一化） | 原30刻度上限 | 原算法/120上限 | 动态算法/120上限
目标突然偏离 | 0.1053 | 0.0467 | 0.0362
目标连续移动 | 0.3769 | 0.2759 | 0.2146

上述是10Hz检测、50Hz轨迹的合成闭环，使用假设的图像/舵机关系；不代表真实跟随误差。速度和加速度均未超原有上限。没有新舵机转动，自动控制保持暂停。声音模型、阈值、相机、两耳工作间距与正式测距状态未改。

加载状态：左右配置和开关已保存；R32控制算法尚未加载，页面会显示“动态追踪待正常重启加载”。需在原运行窗口正常退出并启动程序。此前代停/重启服务被自动批准审查阻止，本轮没有尝试绕过。重启后先核对版本，再进行左右及快慢移动的实物测试。证据：hardware_inventory/av-coordination-20261027。

R31 · 前端工作台 / 已完成软件与页面验证

### 从调试列表，整理为视听感知控制台。

采用深色导航与浅色工作区，实时感知、头部控制、设备与标定、运行日志分为四个页面。首页突出双目画面、声源范围与实际运行状态，可以在双目并排和主视角间切换。显示相机采集帧率、音频格式、视觉候选和自动控制状态；视觉候选不等同于实际人数。

本机真实界面截图，自动转动暂停。截图中的约49.7 fps是当时的采集读数；界面验证不构成新的帧率基准测试或声源角度验收。

原有操作保留 | 163个原有界面标识、77个输入控件的类型/范围/选项、31个操作按钮均逐项比对。Yaw仍为800–2200，中位1500；Pitch为1200–1800，中位1553。左耳CH2、右耳CH3，四路RAW采集保持。
软件验证 | 489项完整回归与41项声音显示检查通过；四个页面分别在390、768、1440像素预览窗口中检查，共12组，无页面横向溢出。浏览器实际连接收到实时画面和状态，检查时没有前端警告或错误。
旧版与恢复 | 7份旧版文件已按SHA256完整备份，并提供恢复说明与脚本。新界面导航保留“旧版界面”，可直接打开原布局。备份位于 positioning_robots/ui_backups/r30-before-redesign-20261027。
加载方式 | 8010控制网页按Ctrl+F5刷新即可，无需重启后端。新版仅增加只读的状态展示入口；Python算法保持R28，R30渐变及结束后保留1秒继续使用。

本次未发送舵机动作，也未进行新的现场录音或实物跟随测试。精确声学角度、远距离人声、多说话人切换、正式测距与实物运动稳定性的验证边界保持原记录。独立证据：hardware_inventory/ui-redesign-20261027。

R30 · 结束后保留1秒 / 仅显示

### 声音停止，方向图与画面范围再保留完整1秒。

R29渐变的现场讲话触发已获操作者确认；本次按反馈调整时间。原先按最后一帧方向结果计时并迅速淡化，现在从方向结束时开始，保持原有颜色强度，满1000毫秒后同时隐藏。新声音出现立即更新，不必等待旧范围结束。

结束后 0–999 ms | 方向图、两眼和主图继续显示同一渐变，注明“仅显示”；保持清晰度，不在这1秒内迅速淡出。
结束后 1000 ms | 范围清除。独立显示计时器每100毫秒检查一次，即使没有新网页消息，也不会永久残留旧范围。
验证结果 | 489项完整回归与41项前端检查通过，覆盖999/1000毫秒边界、持续讲话、重复静音、立即换向、消息中断及四处画面同步清理。属于软件验证，新的保留时间仍待现场体验。

“1秒保留”只改变显示寿命，原始时间戳、声音选人与电机控制不延迟，旧方向不增加确认次数。Python算法、模型和硬件参数保持R28。已有控制页刷新即可加载，无需重启。预览页新增“模拟声音结束”按钮，可独立查看保留效果。

操作者认为方向判断较准确，记录为主观反馈；未据此认定精确角度、多说话人或实物运动已通过。独立证据：hardware_inventory/audio-hold-20261027。

R29 · 显示修复 / R28 后端算法保持

### 中心淡蓝，左右渐隐；正前方也能显示。

修复原方向图没有“正前方”扇区的问题。声音方向范围的显示改为独立检查声学结果，不再等待视觉选人模块接受；没有人脸、视觉时间未对齐时，可靠声音仍可显示。候选选择与电机控制继续执行原有保护。

同一份方向，两个位置显示 | 方向图、左右目与大图使用同一显示状态。中心颜色最明显，按角度向两侧平滑变透明；默认±15°，沿用网页半宽配置。
颜色表示接近程度 | 蓝色强度按角度偏差平滑衰减，不是经统计标定的“该人正在说话”的概率。脸部范围、视觉质量与连续性继续参与原有候选评分。
复现与软件验证 | 旧版正前方结果不亮，已复现并修复；在视觉暂不接受声音的显示对照中，既有录音的303个可用方向窗口由0个可显示变为303个，其中301个为正前方。这是显示修复，不是声学准确率提升。
反例与回归 | 489项完整回归、31项前端检查通过；能量有值但无可靠方向、低人声概率、弱方向置信度、过期、重播和采集异常均不会凭空绘制声源范围。

浏览器渲染检查：真实背景配固定“右20°、±15°”输入；另已检查正前与左侧。此图展示软件着色，不作为新的现场声源定位验收。

“能量有值”与“方向已得到”不同。本轮未标注的数值观察窗口中，后台一直报告 no_voice_activity、方向 unknown；因此该窗口不应画出一个假方向。这不能证明操作者当时是否正在讲话。当前显示修复无需重启服务，已有控制页刷新即可加载；操作者随后确认刷新后讲话能看到渐变；此确认与早前未标注的观察窗口分开保存。精确角度及多人对应仍待验证。

Python算法、VAD模型与阈值、耳位与硬件参数未改。自动转头已暂停；本轮未发出舵机动作，也没有开启新录音。独立证据：hardware_inventory/audio-gradient-20261027。以下R28及夜间记录保留各阶段当时范围。

R28 · 2026.10.27 白天更新

### 声音范围可见，所有人脸参与匹配评分

当前版本已由用户正常重启加载。耳部电平、候选表和双眼预览已在原控制网页核对；自动转头保持暂停，本轮未发出舵机动作。下方 R19–R27 的“待重启”说明是夜间当时的历史状态，以本节为当前状态。

#### 采集与诊断

保留四路 48 kHz / 16 bit WASAPI RAW；左耳 CH2、右耳 CH3，CH1/CH4 只保留采集。网页新增每路电平，并分开说明人声未通过、时差歧义、声音过期和转头噪声保护。

“有输入声音”不等于“有人讲话”，摩擦也不应直接当作说话人方向。

#### 角度范围

可靠声源角度投影到两眼画面，默认淡蓝色 ±15°，可设为 ±10°。投影使用当前每眼方向矩阵，保留倾斜后的坐标关系；超出视野的区域裁到画面边界。

停顿时最多保留约 1 秒的淡化历史范围，并标注“仅显示”；历史显示不增加控制证据。

#### 候选排序与稳定切换

先看声音扇区是否覆盖整张人脸，再综合方向接近度、相对脸部大小、检测质量和连续性。评分最高者仍需连续新观察与切换确认。

声音无效或与视觉冲突时保留视觉；没有人声也能继续视觉跟随。

匹配分 = 0.52 × 方向接近度 + 0.30 × 相对大小 + 0.13 × 视觉质量 + 0.05 × 连续性

此分数是排序依据，不是“这个人正在说话”的统计概率。脸部大小只能近似比较远近；当前两耳不能可靠测量声音距离，因此没有把音量伪装成米制距离。声音方向与画面方向尚未经过精确的外参验收。

实现与软件验证 | 489 项严格回归通过；其中新增 11 项测试，包含 15 个前端显示/投影检查。8 组扇区内竞争场景由选大脸改为选方向更合适的人脸；15 组普通对照、300 次决策保持一致。
真实正常讲话录音 | 本轮 118.26 秒四通道录音中，收到正常讲话，Silero 峰值约 99.7%。离线重放得到 437 个人声窗口、303 个可用方向窗口；目测正前方不是精确角度标签，不能据此宣称角度误差通过。
已加载后的只读检查 | 完整双目 3840×1080；实采约 49.6 fps，双眼推理约 10 fps（本次短窗口）。四路 RAW、耳部映射和音频时钟正常，溢出 0。正式米制距离输出仍关闭。
待现场确认 | 真人讲话时淡蓝色范围与脸框的对应、多人的实际切换、轻声与远距离、舵机偶发无反馈及实物跟随顺滑度。本轮未做这些验收。

问题时间线已更正：“讲话、摩擦但没有响应”发生在此次诊断之前约十分钟；用户本次回复“完成”对应的是按要求进行的正常讲话，没有摩擦。后来录到正常人声不能解释此前未录制片段的具体失败原因。语音阈值、模型和声源定位 DSP 本轮没有调整。

本次启动警告说明（MediaPipe 1.1.0）

InitializeLog：初始化前的原生日志输出到终端错误输出，是日志去向提示。feedback tensors：模型签名不支持该反馈连接，库禁用这一内部机制；它不是舵机位置反馈故障。

NORM_RECT：姿态模块的内部关键点投影使用未传入图像尺寸的裁剪接口，对应官方版本生成方形 ROI。本次核对没有发现推理或双目采集中断；此结果不等于关键点精度验收。没有通过屏蔽警告掩盖异常。

来源：模型反馈实现 (https://github.com/google-ai-edge/mediapipe/blob/v1.1.0/mediapipe/calculators/tensor/inference_feedback_manager.cc)；关键点投影实现 (https://github.com/google-ai-edge/mediapipe/blob/v1.1.0/mediapipe/calculators/util/landmark_projection_calculator.cc)。

证据独立保存在 hardware_inventory/audio-visual-score-20261027-124942；R27 夜间快照及交接原文保留。下面的旧版章节描述各阶段当时的实现和验证范围。

### 夜间历史交接：当时保留 R27，等待重启。

源码已验证 · 原服务暂停

本轮收尾未发现新的集成失败，保留现有算法。当前 8010 服务仍为原 R17/R18 版本，夜间修改尚未载入；没有进行真实舵机动作。

已有回归 | 478 项全部通过，当前源码哈希一致生产源码保持 R27，本轮只新增集成验证与交接说明；各轮独立证据与快照保留。
本轮串联检查
恢复边界 | 先确认位置，再接受明确的新目标模拟串口确认只读重连不重放旧轨迹。输入重连、单眼遮挡及停止取消已在分阶段模拟中通过；实物稳定性仍待确认。
未解决的实测问题 | 轻声、残余反向、远距离、持续 60 fps 与实际跟随正式测距仍关闭，手动镜头不能通过软件获得电动对焦。既有录音及合成输入不替代这些现场验证。

此前自动批准审查拒绝停止并重启服务，仅返回“blocked by policy”。夜间未重试；新源码待用户正常重启加载，自动动作保持暂停。

展开完整交接清单与正常启动入口

### 声音选人只累积新的观察，编号重置后重新确认。

R27 · 软件已验证，待加载

模拟输入复现：两个音频编号反复交替，也会被旧版累计为多次确认，最终可能换到声音指向的小人脸。现在编号与接收时间都前进才增加确认次数；相同快照可保留已有证据，但不会重复计票。编号回退或复用且接收时间更新时，先清除旧确认，从新输入开始累计。

重复与重播保护 | 旧时间或乱序数据不能降低已接受的时间基准同一编号、同一时间的缓存快照不增加次数；时间不前进而编号增加也不视为新证据。视觉选择继续运行。
故障注入
正常选择对照
重启后的恢复
完整回归
验证边界 | 声音仍辅助选择可见人脸，最终方向来自视觉录音方向时间线配合的是合成人脸，属于决策兼容性验证，不能当作新的现场声画测试。没有显式设备会话编号时，计数回退采用保守重确认；两个时钟都被伪造为前进的数据仍无法仅凭这些字段识别。

人声模型、时差估计、双目参数、舵机参数与视觉优先策略不变。原 8010 服务保持旧版暂停，新源码待正常重启；此前自动批准审查拒绝停止并重启服务，仅返回“blocked by policy”，本轮未重试。未进行新录音或真实舵机动作。

### 一份音频快照，同时确定声音、编号和时间。

R26 · 软件已验证，待加载

模拟复现了采集线程与算法读取交错时的问题：旧版先读最新编号，再读取声音窗口；中途收到新数据或重连后，可能把新声音配上旧时间。现在只读取一次受采集锁保护的窗口，以该窗口末尾确定采样时钟、编号和接收时间。

原问题 | 首轮模拟中，1920 帧声音被配上 960 帧的结束时钟语音检测收到 −960 的起始位置，方向算法报告采样时钟无效；这属于数据与时间不一致，不能据此认定设备采样率有问题。
回调与重连验证
正常回放对照
完整回归
仍保留的保护 | 重复快照不增加语音或方向证据；溢出和缓冲清空仍退回未知左耳 CH2、右耳 CH3；身体 CH1/CH4 继续排除。四通道 RAW、48 kHz、16 bit PCM、13.55 cm 工作间距估计与零点均未改变。
验证边界 | 修复数据一致性，没有修改语音模型或方向估计算法既有录音不是新的独立现场验收；未证明真实轻声识别、远距离或精确角度得到改善。没有新录音、实物舵机操作或正式测距。

原 8010 服务仍为旧版暂停，新源码待正常重启加载。此前自动批准审查拒绝停止并重启服务，仅返回“blocked by policy”；本轮未重试。

### 连接更换后，旧轨迹停止等待位置同步。

R25 · 软件已验证，待加载

在模拟连接中复现：旧轨迹可能借助串口重连，在新连接上继续启用和发令。现在轨迹绑定创建时的有效连接；连接失效或更换后，旧轨迹停止并保留故障，正常的位置同步流程需要创建新的轨迹器。

连接保护 | 核对连接与发送当前指令在同一次通信保护中完成连接在准备过程中失效也不会借机打开新连接。创建轨迹器时读取连接标识不等待串口操作，保持停止意图的处理通路。
故障模拟
正常轨迹对照
完整回归
恢复规则 | 旧轨迹器不会因重新读取位置而自行恢复完成新的位置同步后，以新测得位置创建轨迹器，再接受明确的新目标。连接保护不代替位置反馈。
验证边界 | 全部为模拟连接、反馈与执行连接不变的硬件复位仍依赖位置反馈监测；此前实物无反馈的物理原因尚未确认。已发给驱动的写入不能撤回，真实停止延迟与机械顺滑度未验收。

原 8010 服务保持旧版暂停，R25 源码待正常重启加载。此前自动批准审查拒绝停止并重启服务，仅返回“blocked by policy”；本轮未重试，没有打开或写入真实舵机端口。

### 低信噪比语音评估：保留现有流程。

R24 · 评估时未改算法，基于 R23

用已保存的参考人声建立受控加噪对照，比较两个轻量高通候选。两个候选只有小幅变化，未达到事先设定的采用条件；本轮保留现有 VAD、模型和阈值，没有把试验前处理接入主程序。

数据划分
评估含义 | 统计干净参考语音证据在扰动后保留了多少参考音频没有人工逐帧标注，证据由原模型在干净片段上定义。这是受控扰动下的稳定性指标，不能称为召回率、F1 或识别准确率。录制的室内背景也可能含偶发人声。
候选结果
反例
信噪比核对 | 按相同的 6 秒人声插入区间定标信号与噪声覆盖两档音量、−5 / 0 / 10 dB 受控信噪比；记录实际计算值并检查定标误差。核对时修正了初稿按整段噪声定标的口径；初稿记录保留，最终统计使用独立的 exact-snr-v2 目录。
源码与回归

方法参考：Silero 维护者关于预处理与场景验证的说明 (https://github.com/snakers4/silero-vad/discussions/276)、官方流式状态与分块说明 (https://github.com/snakers4/silero-vad/wiki/FAQ)。继续使用本地预训练模型，没有训练新网络。

本轮没有证明真实轻声检测或远距离效果改善。原 8010 服务仍为旧版暂停；此前 R19–R23 源码待正常重启加载，自动批准审查曾拒绝重启，仅返回“blocked by policy”。本轮没有重试或发送舵机动作。

### 停止控制：取消仍在等待的旧请求。

R23 · 软件已验证，待加载

补上 R22 发现的取消问题：每次控制请求都携带当次有效编号，停止或新请求到达后，旧编号立即失效。进入工作线程、取得控制锁和完成位置读取后都会重新核对；被取消的旧请求不能继续提交动作，也不能清除更新的通信故障。

等待阶段取消
迟到轨迹处理
正常行为对照
网页链路 | 开始、手动目标、方向箭头和诊断动作携带请求编号网页请求尚未进入工作线程时也可作废。停止不等待位置查询或控制锁；预期取消不会被自动跟踪循环锁定成通信故障。
完整回归
实物边界 | 已交给驱动的写入无法撤回本轮保证等待阶段不继续提交旧动作，并清除迟到的排队轨迹；没有证明真实串口停止延迟、机械制动或实物顺滑度。全程使用模拟反馈与执行器，没有操作真实舵机。

8010 原服务继续暂停。此前自动批准审查拒绝停止并重启服务，仅返回“blocked by policy”；本轮未重试，R19–R23 已验证源码待正常重启加载。

### 控制链路：新串口连接不沿用旧启用状态。

R22 · 模拟验证，待加载

复现了一个连接状态问题：旧串口关闭后，程序可能继续相信舵机“已经启用”，在新连接上漏发启用指令。现在只在同一个有效串口连接内复用启用状态；连接失效或重新打开失败时，旧状态也会清除。

连接与缓存 | 先检查连接，再判断是否需要启用单轴、双轴和连续指令共用这条规则。启用操作使用同一把通信锁，避免两个并发请求重复启用同一轴。
重连故障模拟
正常指令对照
只读重连 | 只发送位置查询清除旧缓存不会主动启用或转动舵机；后续显式控制请求才按新连接重新准备。新增缓存失效日志和诊断状态，方便后续对照实际通信记录。
完整回归
后续处理 | 旧手动请求取消问题已由 R23 补上R22 用模拟反馈等待复现了旧总控问题，原始证据保留；上方 R23 展示取消保护的软件验证结果。两轮源码都尚未加载到实物主程序。

本轮仅用模拟串口，没有打开或写入真实舵机端口。没有据此认定此前实物“无位置反馈”的物理原因已解决，也没有实物顺滑度验收。

当前 8010 原服务继续暂停；R19–R22 源码待正常重启加载。此前自动批准审查拒绝停止并重启服务，仅返回“blocked by policy”；没有通过其他方法重试。

### 双目恢复：画面中断后，重新确认再跟随。

R21 · 离线验证，待加载

复现了一个时间连续性问题：检测结果中断约 0.85 秒后，原逻辑会在第一张恢复画面上沿用中断前的配对和控制确认。本轮让关联、声音选人和控制视角的确认次数在较长中断后重新累计，避免把断开前后的观察视为连续证据。

恢复规则 | 中断超过 0.75 秒，重新确认当前目标沿用现有画面失效窗口；恢复后的新坐标可以显示，但需要至少 3 次新观察、跨越至少 0.12 秒，才恢复控制就绪。身体麦克风、相机对齐和舵机参数保持原配置。
中断模拟
正常时序对照
真实样张回放
严格回归
验证边界 | 实现与离线验证完成，尚未加载到实物主程序模拟时间不是舵机响应时间；数字遮挡不是现场遮挡。没有新增录像、测距、实物顺滑度或多人识别准确率验收。原服务继续暂停。

此前自动批准审查拒绝了停止并重启本地服务，仅返回“blocked by policy”。本轮没有重试该操作；R19–R21 已验证源码均待正常重启加载。

### 选人稳定性：异常声音数据自动退回视觉。

R20 · 软件已验证，待加载

检查发现：只判断“置信度低于阈值”会漏掉 NaN、无穷大和超过 1 的异常数值；无效时间戳也可能绕过声视同步检查。本轮统一检查声音证据的数值范围、时间戳和采样序号，不改变视觉优先的选择原则。

声音证据入口 | 先检查有效性，再参与人脸选择概率必须是 0–1 的有限数值；方向与不确定度限制在算法定义的范围；时间戳有效且足够新；采样序号为非负整数。坏数据不累计换人确认次数，不输出旧方向。
故障注入对照
正常行为对照
完整回归
验证范围 | 软件异常保护与决策稳定性这些场景来自模拟输入，不是新增实物测试。没有提高人声检测阈值、修改耳部通道或声学零点，也没有证明轻声、远距离和准确测角已改善。
运行状态 | 8010 主服务保持原版暂停；R19/R20 已验证源码待加载此前自动批准审查拒绝了停止并重启本地服务，仅返回“blocked by policy”。没有通过其他工具重试，也没有发送舵机动作。重启限制不影响离线源码验证和本汇报更新。

### 夜间离线改进：跨侧突跳确认与 PCM 时钟去重。

R19 · 源码已验证，待加载

用现有录音和合成信号继续验证，不要求新的实体配合。新增方向时间保护：只有持续的新音频证据才能确认突然换到另一侧；同一段 PCM 的重复调用不能增加证据。暂不可靠的当前窗口返回 unknown，不继续输出上一方向。

方向突跳 | 按真实 PCM 采样时钟确认，避免按网页轮询次数累计使用已接受的短时中位时差作为参考；大幅跨侧变化需持续证据，同侧幅度变化和接近中间的小幅变化继续保留。真实换边的合成信号在约 0.10 秒后恢复可用新方向；这不是实物转动延迟。
旧新录音回放
反例与回归
轻声处理 | 简单频谱降噪暂未接入个别片段的 VAD 分数提高，但未恢复三段持续人声，部分设置增加背景触发。当前没有足够证据说明轻声检测改善；人声阈值和本地预训练模型保持。
未采用的方案 | 全方向大跳变门控、独立原始时差均值参考前者会额外拒绝较多同侧有效证据；后者与输出的中位方向不一致。实验结果保留，采用范围更明确的跨侧确认和同一可靠参考。

这些录音在前阶段已被查看；“留出”仅指本轮调试中保留的对照材料，不是全新的实物验收。窗口彼此重叠，保留率和反侧窗口数均不是实际测角准确率。轻声、远距离和精确零点仍未验收。

加载状态：自动批准审查拒绝了停止并重启本地服务的操作，仅返回“blocked by policy”，没有更具体原因。当前 8010 主程序仍运行原版本；R19 改动和验证记录已保存，需重启后才能使用。自动转头持续暂停，本轮没有发送舵机动作。

### 新录音验证：正常音量下，近场三方位顺序基本一致。

R18 · 约半米实物检查

本轮保留 R17 的算法、阈值和零点，在新录音上验证。先按操作者要求将头部回到保存的正前与水平目标，再保持不动。录到轻声三方位、正常音量大致正前方、正常音量右前与左前；全部原始四路 PCM 与实时状态均保存。

操作者确认的位置 | 人声窗口中可用方向 | 新版中位方向 | 结果与限制

右、左片段按操作者确认的先后顺序和停说间隔标注，不根据算法输出挑选方位。正前录音中的几次停顿仍属于同一个大致正前方位置。窗口每 20 ms 重叠更新，上表比例表示输出可用性，不是实际测角准确率。

绿色为 R17，橙色为旧 R16。新录音未用于调整参数；目测正前与左右位置没有精确量角，图中中位数不能作为测角误差。

正常音量 | 三处均有高置信度人声，方向中位顺序为右 → 大致正前 → 左右侧输出仍较断续，约 4.5% 的可用窗口落到反侧；左侧多数输出为左。当前方向仍适合作为视觉选人的辅助证据。
轻声测试 | 本轮未形成稳定人声段操作者确认先前声音较轻；该段 VAD 峰值约 0.399，未越过当前人声门控。离线倍增音量及高通对照未恢复三段持续语音；没有因此修改生产阈值或宣称通过。
采集与代码 | 四路 RAW 正常，三轮均无溢出或录音丢块左耳 CH2、右耳 CH3，身体 CH1/CH4 排除，工作间距仍为估计的 135.5 mm。生产源码未改动，与 R17 的 390 项通过测试对应源码一致；本轮没有再次训练网络。
回中与控制 | 命令目标 Yaw 1500 / Pitch 1553，录音期间头部保持静止实测反馈约 Yaw 1505–1507 / Pitch 1544；没有用显示的命令目标代替实测位置，也没有更改已保存的水平基准。自动跟踪持续暂停。
远距离 | 操作者暂不方便，未测试已停止远距离录音；其间背景数据未计入方向验证，不推断 1–2 米或更远处效果。

后续仍需改善：轻声条件下的人声检出、右侧方向的输出连续性和少量反向结果。当前数据只支持近场、正常音量的定性检查；实际角度、正式声学零点、远距离和完整自动跟随尚未验收。

### 用频段可靠性加权，让两耳时差恢复可用。

R17 · 算法升级与回放验证

针对 R16 人声已检出、方向却大多为 unknown 的问题，本轮用保存的完整 RAW 录音重放并修改生产算法。左耳 CH2、右耳 CH3；按实物估计间距采用 135.5 mm，身体 CH1 / CH4 不进入定位、人声检测或背景噪声估计。没有训练新的神经网络。

1 / 人声与频段可靠性

沿用本地 Silero 人声模型。无声窗口更新两耳的背景功率谱；192 ms 上下文拆成多个重叠短帧平均，计算频率相干性，降低背景噪声和不一致频率的权重。

2 / 加权互相关与物理约束

采用部分白化的 GCC，保留可靠语音能量。检查归一化相关、相干性和真正独立的竞争峰。超出两耳物理时差的峰直接拒绝，保留亚采样峰插值。

3 / 短时稳定与视觉协作

对最近可靠时差取中位数。短暂质量下降仅保留内部候选，当帧仍输出 unknown；持续失败、静音或采集断流清除历史。单个候选不能触发动作，视觉优先策略继续执行。

几何与符号 | τ = t右 − t左；θ ≈ asin(343τ / 0.1355)正值为小熊左侧，负值为右侧。最大时差约 395 μs，即 48 kHz 下约 19 个采样；零点补偿仍为 0，没有用大致正前方位置强行归零。
频谱加权 | 多帧相干性 × 相对背景的语音余量 × 部分白化使用约 200–6000 Hz 宽带信息，每个频率权重不同；不是只比较频谱音量，也不把单频相位的模糊界限当作全部语音的截止频率。两耳使用相同处理，原始四通道录音保留。
保护与诊断 | 静音、纯音、削波、复制通道、时钟异常与过期数据继续隔离主程序诊断新增频段权重、相干性、相关峰和背景学习窗口数。置信度和时差质量分数是工程门控，尚未校准为真实测角误差。

#### 同一段录音，旧版与新版对照

操作者确认的位置 | 可用方向窗口 | 新版中位方向 | 定性区域一致比例

回放每 20 ms 更新，窗口彼此重叠，不是相互独立的样本。实际运行人声模型；只有人声概率 ≥ 0.5、方向置信度、时间稳定性与不确定度同时满足现有选人条件才计数。旧版额外改用 192 ms 仍未明显改善，说明提升并非仅来自加长窗口。135.5 mm 为操作者估计值，间距修正也不是主要提升来源。

灰色区域为约定的说话时段；点表示通过门控的方向。未通过的窗口不填成正前方，也不继续输出旧角度。

启动阶段曾出现短时采样到达速率不匹配，保护门控已阻止其参与定位并写入故障／恢复日志；随后单独测量的约 15 秒稳定采集正常。启动阶段原始状态与稳定阶段分别保存，未删除异常记录。全套复核还发现旧标定测试对单个畸变系数的容差存在数值波动：保留训练输入隔离及内外参比较，改为检查相机投影变化小于 0.01 px；标定生产代码和当前对齐参数未改动。

仍需实物确认：录音的位置约为 40–50 cm，未测量真实方位角；该录音同时用于开发和回放，不能视作独立验收。左前段仍有部分窗口接近正中，严格的“三段均至少 75% 落在各自方向区域”开发目标未全部达到。下一次需在新录音上检查固定左／中／右位置，再比较更远距离与其他说话人；当前不宣称精确测角或分离同时说话者。自动转动保持暂停，本轮未测试舵机运动。

计算依据与可复现记录

多帧平均相干性的定义参考 SciPy 官方说明 (https://docs.scipy.org/doc/scipy/reference/generated/scipy.signal.coherence.html)；互相关时差参考 GCC-PHAT 官方说明 (https://www.mathworks.com/help/phased/ref/gccphat.html)。这里实现了项目所需的噪声和相干性加权，并非直接调用这些网页的示例。代码与全部录音摘要、反例测试、逐窗口回放、源码哈希和真实采集状态保存于 hardware_inventory/audio-reliability-20261026。

### 重新插拔后采集恢复，重新确认左右耳。

R16 · 当前实测

本轮相同算法代码下，重新插拔 YDPI4MIC 后恢复正常 RAW 四通道采集。操作者确认先摩擦小熊右耳、再摩擦左耳；实测对应 CH3、CH2。本机配置已更新为小熊左耳 CH2、右耳 CH3，身体 CH1 / CH4 继续排除。

采集格式 | 4 通道 · 48 kHz · 16 bit PCM · WASAPI RAW8 秒短测实际收到约 48,063 采样帧/秒；后续两段录音约 180 秒与 171 秒，均无缓冲溢出、无录音丢块。
左右参考 | 以小熊自身为准面对小熊时，操作者左侧是小熊右侧。旧表与本次实测不一致，当前以本次逐耳信号和操作者确认结果为准；不把差异归因为“USB 自动交换通道”。
人声检测 | 右前 → 正前 → 左前三段均触发距离由操作者修正为约 40–50 厘米；人声概率峰值约 0.975 / 0.996 / 0.994。这是人声活动概率，未做文字转写或说话人身份识别。
方向稳定性 | 尚未通过本轮检查右前段曾输出右侧约 48°；正前和左前段主要因频段不一致、时差峰不明确而返回 unknown。保留门控，不把未知方向当作 0°。
程序与控制 | 通道配置已加载 · 自动运动暂停算法源码与 R15 的 378 项通过版本相同，本轮没有重复把软件测试当作实物验收。相机与舵机参数保留，未发送运动指令。

#### 按实际操作顺序记录的三段结果

实际方位 | 人声概率峰值 | 抽样中的有效方向 | 结论

每 0.5 秒抽取一次主程序状态，不是全部音频窗口的准确率统计。方位为操作者确认的定性位置，未测量实际角度，约 40–50 厘米也不作为标定距离真值。

完整原始录音和时间线均保存；图中逐耳片段显示后半段实际操作，避免把前期等待画面误作测试结果。

下一步：使用已保存录音排查频段可靠性、时差峰选择和方向时间稳定性；先做离线对照，再验证固定方位。当前三段大致位置不足以校准精确零点，不通过手动放宽门槛把结果改成“通过”。硬件异常的具体 USB / 驱动 / 板卡根因仍未确认，重插恢复不等同于长期稳定性验收。

### 26 项遗留问题：逐项重测与处理结果

R15 · 当前验证

26 项原失败均重新复现。17 项由代码修复直接消除，5 项同时修复代码与测试条件，4 项修正过期测试。没有删除或跳过原测试，也没有降低定位与运动保护门槛。

378 / 378全套软件测试通过 · 0 失败 / 0 错误 / 0 跳过

26 / 26原遗留回归已逐项处理；与实物验收分开记录

双轴 3 轮反馈只读成功 · 本轮未发送转动命令

实测新增发现：四通道 RAW 输入本次出现高噪声和采样到达速率异常。已比较回调／阻塞读取及多个位深，仍可复现；普通共享模式则又变成近似相同的四路。根因仍待 USB、Windows 驱动与板卡对照。异常音频现在会被隔离并记录日志；视觉优先策略继续独立工作。

查看类型： 26 项

序号 | 原问题 | 根因与处理 | 结果

公共视觉方向已与手动左右／上下保持一致；新渐进控制原有的符号补偿同步移除，本机已确认的镜像设置和安装方向保留。左右范围仍为 800–2200，上下 1200–1800，水平基准 1553。

#### 四麦数据完整性复核

保留 4 通道、48 kHz、16 bit PCM 的项目配置，WASAPI RAW 流选项为 1。左耳 CH3、右耳 CH2 进入定位与语音判断，CH1/CH4 仅保留原始录音。现在同时检查原始 PCM 的实际到达速率，不能只看配置是否写着 48 kHz。

各模式顺序测量，录音未包含受控方向说话测试。RAW 四路不同不等于信号正常；普通模式四路近似相同不能用于双耳定位。

#### 仍需要哪些条件才能确认

项目 | 当前结论 | 需要的实测条件

本轮相机：3840×1080、请求 60 fps；约 15.04 秒收到 498 帧，约 33.12 fps，未出现无效 JPEG。图像对齐参数保持，米制距离输出继续关闭。舵机能读回位置不代表运动过程稳定或机械边界已通过。

RAW 接口语义参照 PortAudio WASAPI 文档 (https://files.portaudio.com/docs/v19-doxydocs-dev/pa__win__wasapi_8h.html)；RAW 仍可能包含端点固定处理，见 Microsoft 音频流选项说明 (https://learn.microsoft.com/en-us/windows/win32/api/audioclient/ne-audioclient-audclnt_streamoptions)。本次没有把接口标志视作完整硬件验收。

### 视觉确认目标，声音提供搜索扇区。

R12 · 当前启用

没有可靠声音时，优先较大的可信人脸；有可靠声音时，先在约 ±15° 的扇区内找实际可见人脸，再按大小与角度接近程度选择。声视没有对应时保持视觉，最终转向位置始终来自新画面。

01 / 先有视觉目标两眼分别检测、保守关联。无声时优先较大人脸；已有目标保持连续，明显更大的新目标持续出现后再换人。

02 / 声音给一个区域中心 0°，左、右方向有角度。默认搜索声源周围 ±15°，比较整张脸的角度区间；扇区内优先大脸，大小相近再比较角度。

03 / 多段连续靠近看偏差 → 有界小步调整 → 看新画面。较大 / 中等 / 精细三段逐渐减小调整幅度，50 Hz 轨迹保持连续，不需要先知道几米。

角度范围按当前画面计算

正在读取当前对齐画面的近似有效视野。

例如声音在右 67°，±15° 对应右 52–82°；如果该区域没有进入当前视野，就不会强行匹配。人脸面积只近似表示远近，未当作准确距离。

#### 按新规则执行的选人回放

以下使用合成候选与声音输入验证规则，不是现场多人识别录像。短暂丢失期间不输出旧坐标。

视觉主导 | 可信人脸大小优先 · 连续性保护声音扇区内有实际可见人脸才辅助选人；没有对应、没有人声或声音过期时以视觉为准。
有限扇区 | 默认 ±15° · 可设 5–30°按整张脸的角度区间匹配。大小相差约 12% 以内再参考角度接近程度；方向不等同于声纹身份。
分段逼近 | 较大 / 中等 / 精细 → 保持当前单次最大 30 刻度时，三段上限为 30 / 12 / 4；实际步长还受图像误差、死区、机械范围和连续轨迹限制。
采集验证 | 746 帧 / 15.05 秒 ≈ 49.58 fps两眼各检出 1 张人脸，当前使用有效单眼方向；本次纹理分布检查未通过，未强行合成共同方向。双目成对处理近期约 14.51 fps。
软件验证 | 新增 30 项通过 · 全套 324 项仍保留此前 24 个失败、2 个错误，无新增回归。真实照片数字遮挡 5 / 5；六阶段合成选人、虚拟延迟闭环及轨迹连续性检查通过。
当前边界 | 自动转头与米制距离仍关闭耳部与相机朝向偏移、同时多人说话、真人选人和实物顺滑度尚未验收；图像中心零点是方向参考约定。

查看分段逼近与连续轨迹的软件模拟

虚拟相机和执行器的刻度关系为测试假设；未使用真实距离，不代表实际机构的收敛或顺滑度保证。

查看更新后的原控制网页

设计参考 Chaumette 与 Hutchinson 的视觉伺服教程 (https://faculty.cc.gatech.edu/~seth/ResPages/pdfs/ChaHut07.pdf)：持续减少图像特征与目标位置的误差。本项目实现的是有界两轴增量控制，未引入完整六自由度交互矩阵。

### 上下触发更灵敏，运动状态有实测依据。

R13 · 控制稳定性

现场出现过位置反馈间歇中断，同时上下箭头可用、自动跟踪俯仰不明显。排查记录显示：俯仰目标曾到数值上限 1800，原来的上下触发门槛也高于左右。目标位置与实际位置现在分别显示。

上下触发 | 进入约 2% 画面高度 · 退出约 1.2%默认归一化门槛 0.04 / 0.024，替换旧的 0.10。连续两张新画面、同向持续至少 40 ms 才确认；显式设置的门槛仍优先。滤波延迟过中线时停止旧方向修正。
逐轴实测 | 运行时约每秒查询 · 连续两次无效则停车启动与人工点动先读取相关轴位置。静止时最多重开串口一次，再重新读取全部所需轴；失败后保持停止，不猜测位置，不自动重放动作。
可解释状态 | 等待新画面 / 确认方向 / 持续跟随 / 已到限位勾选视觉跟踪与启动自动控制分别显示。保留水平基准 1553、俯仰范围 1200–1800；自动左右映射按用户实物反馈修正，手动箭头符号保留。
故障记录 | 运行日志 + 原始串口收发日志本机 logs/runtime.jsonl、logs/serial.jsonl；各文件 5 MiB，四份轮转备份。保存时间、请求编号、原始回复和耗时，重启后仍保留；不记录图像像素或音频采样。
实机小步 | 下：1561 → 1536 · 上：1536 → 1558分别发送 ±30 刻度俯仰点动，两个方向的实际位置反馈符合预期。这里只验证俯仰小步响应，不等同于完整自动跟随、角度精度或长期稳定性验收。
软件验证 | 新增 20 项通过 · 全套 344 项无新增失败原有 24 项失败、2 项错误仍保留。覆盖新画面触发、抖动与方向反转、旧帧不驱动、只读恢复、故障锁定、停止取消启动及采集停滞恢复。
采集停滞 | 旧画面过期后清除 · 后台有界重连此前条纹已存在于原始采集 JPEG，且最后一帧停留超过两分钟。已加入停帧监视、重启退避与旧会话隔离。最近短窗口约 59.8 fps，不作长期 60 fps 保证；底层条纹成因仍未确认。

新版控制网页；自动转动暂停，完整真人跟随效果待现场验收。

当前结论：俯仰具备正常动作能力，自动触发和可观察性已改进；间歇反馈故障的物理根因尚未证实。正式双目距离输出与标定验收条件保持原状。

### 左右软件行程统一为 800–2200。

R14 · 配置与控制链

按用户指定扩大左右轴的允许行程，中位仍为 1500。上下轴保持 1200–1800，水平基准仍为 1553。数值为舵机位置刻度，尚未换算为实际角度。

左右轴 | 最小 800 · 中位 1500 · 最大 2200默认配置、本机配置、示例配置、逻辑限幅、轨迹规划、反馈校验与诊断接口均采用该范围。
网页同步 | 范围输入框 + 滑块 + 后台统一预设当前预设为 800 / 1150 / 1500 / 1850 / 2200，俯仰均使用 1553。修改方向或非对称行程后，预设按配置重算；调试曲线坐标也随范围调整。
控制节奏 | 保留 50 Hz 连续轨迹、速度与单次步长扩大总行程不改变速度、加速度、jerk 或单次视觉调整上限。保存范围时暂停自动控制，并要求重新读取位置。
验证结果 | 新增 16 项通过 · 全套 360 项无新增失败R14 当轮仍有 24 项失败、2 项错误；R15 已逐项处理。覆盖新端点与越界、跨越旧边界、整段轨迹、串口编码、参数持久化、诊断接口和网页绑定。
验证范围 | 新版服务已加载 · 自动转动暂停离线测试使用模拟舵机；部署检查没有打开舵机串口，没有执行实物 800/2200 端点动作。实物机械极限与全行程顺滑度仍未验收。

网页范围与后台配置一致；截图为参数检查，没有执行转动。

### 声音辅助选人，视觉持续跟随。

R11 · 历史声视策略

人声和稳定方向帮助从多张脸中选目标；锁定后，视觉可以在安静时继续工作。两眼共同参与候选生成，可靠纹理对应时共同计算方向。方向跟随与米制测距分别处理。

01 / 两耳提供声音线索四路 RAW 采集 → 仅选 CH3、CH2 → Silero 语音活动 → GCC-PHAT 时差 → 多频段与时间稳定性。身体两路排除。

02 / 两眼共同提供候选同帧分眼 → 共同对齐 → 左右独立找脸 / 跟踪 → 唯一纹理对应 → 共同射线方向；对应不足用有效单眼。

03 / 选人、保持与平滑方向与全部人脸区间比较 → 明确优势与连续确认 → 稳定锁定 → 时间平滑 / 限值轨迹。声音失效回退视觉。

#### 一个小脸说话，大脸保持安静，会选谁？

以下按钮读取算法实际执行的八阶段合成回放。目标 1 为右侧较大人脸（−25°），目标 2 为左侧较小人脸（+25°）；左右以人头自身为准。这不是现场真人识别录像。

人声判断 | 本地 Silero ONNX · 预训练权重只判断是否有人声；不识别语言、身份或实际说话人。本项目没有训练新网络；模型来源、许可证和校验值已保存。
稳定选人 | 至少 3 次新音频确认 / 至少 0.18 秒换人持续至少 0.35 秒。模糊、过期和电机保护期间不让声音推翻视觉锁定；同一个音频序号不重复累计确认。
双目方向 | 共同方向链已实现 · 合成几何验证通过不使用米制基线长度、Q 或 XYZ。旧人脸照片的纹理对应被拒，正确回退二维观察；当前尚未验收真实人脸共同方向精度。
遮挡与轨迹 | 真实照片数字遮挡：5 / 5 检查通过遮住任一侧使用另一侧；两侧都遮住清除目标；恢复后重新识别。加入短时编号重置衔接；不等同于实物遮挡或身份识别验收。
实采与运行 | 994 帧 / 20.04 秒 ≈ 49.61 fps双眼成对处理近期约 15.75 fps。四路录音 0 溢出 / 0 丢块；Silero CPU 平均约 0.32 ms / 次。现场无人脸，未据此评价真人跟随。
软件验证 | 新增 29 项通过 · 全套 294 项仍保留此前 24 个失败、2 个错误，无新增回归。自动转头关闭；平滑轨迹已选用，未打开舵机串口。

当前可用的是方向辅助和稳定视觉保持。正式距离继续关闭；相机与耳部朝向为名义对齐。两耳前后歧义、同时多人说话、真人选人效果、物理转向和角度精度仍需在场验证。

查看声音与选人的软件回放曲线

官方 60 秒语音注入 ±9 采样点时差，参考角 ±29.22°，通过窗口的符号均正确，角度误差 P95 约 0.32° / 0.30°。静音、白噪声、纯音各 5 秒无最终有效方向；3 秒摩擦录音仍有 1 个短暂误报，所以另加连续确认。数值是模拟回放结果。

查看更新后原控制网页

方案调研：采用 Silero 官方预训练 VAD (https://github.com/snakers4/silero-vad)，复用已有 ONNX Runtime。 SRP-PHAT 阵列方案 (https://pyroomacoustics.readthedocs.io/en/stable/pyroomacoustics.doa.srp.html)需要明确的咪头坐标，身体尚未装配，暂缓； TalkNet 视听说话人方案 (https://github.com/TaoRuijie/TalkNet-ASD)需要音画片段与模型链，本轮保留已有可选实现，没有增加为主路径依赖。

### 2026.10.25 · 双目几何算法优化

R10 · 历史几何优化

本轮完成求解、诊断和空间匹配检查的代码升级。新的参数仍未通过正式测距检查，实时继续使用 R09 的图像对齐预览。

独立验证划分 | 同一 65 组参数拟合 / 18 组验证 · 83 个历史候选按 4 秒采集片段分组，验证边界隔离 0.7 秒；与 R09 的 67/16 划分不同，不能直接把两版误差差异称为精度提升。
抗异常点估计 | 投影 P95：4.74 → 4.56 px行误差 P95：1.60 → 1.51 px。Soft-L1 联合估计保留全部角点，验证数据不参与优化，不通过删除验证点降低误差。
逐样本诊断 | 25 个姿态出现平面拟合警告记录每姿态及每角点残差。警告可能来自纸面、运动、检测或镜头模型，尚不能确定物理原因。
空间匹配检查 | 纹理一致性 / 特征分布 / 小视差噪声允许两眼亮度差，集中或共线特征拒绝距离；记录拒绝原因。测量噪声估计不包含标定、尺度或镜头模型误差。
软件与运行验证 | 60 项相关测试通过 · 全套 265 项保留 24 个失败、2 个错误，无新增回归。部署后双眼同帧处理、原预览和距离关闭检查通过；自动转向关闭。
当前边界 | 新模型 rejected · 未替换现有预览投影 P95 4.56 px 仍高于 3；左目 RMS 1.531 px 高于 1.5。历史数据回放不代表新的独立实物精度验收。

这里的“拟合”是求相机参数，没有训练新的神经网络。65 组用于估计镜头内参、畸变及两眼相对姿态，18 组用于检查泛化。现有 SCRFD 预训练模型负责在两眼中找人脸。3 px 是本项目当前测距检查线，不是通用行业标准；4.56 px 是角点投影偏差，不能直接换成厘米。实际验收应分别检查目标方向、跟随稳定性和不同距离的测距偏差。

查看部署后原网页状态

### 2026.10.25 · 双眼实时对齐预览

R09 历史对齐 · 当前仍使用

两眼共同去畸变、校正相对倾斜，并裁取同一个有效矩形。原网页可切换原图对照；当前保留二维识别，正式测距未通过。

全量复核 | 235 张存档全部检查 · 188 张有共同角点网页本组另保存 15 组稳定样本。严格运动筛选与姿态去重后为 17 组，不足 20 组，未据此拟合。
探索性诊断 | 83 个不同姿态 · 67 拟合 / 16 留出包含未满足稳定窗口的帧；只按角点与姿态去重，不按拟合残差挑帧，不能作为正式标定验收。
图像对齐 | 每眼 1836×1050 · 原像素面积约 93%留出行误差 P95 1.64 px；单目 RMS 1.486 / 1.345 px，双目 RMS 1.566 px。裁切面积占比不等同于角度视野保留率。
测距状态 | 右目投影 P95 5.78 px（需 <3）保留正式拒绝结果；calibrated=false、距离输出关闭。预览不提供三维投影或 Q；未核验纸面平整度和已知距离精度。
实时验证 | 1003 帧 / 20.22 秒 ≈ 49.60 fps3840×1080 原始 MJPEG 保留；两眼检测使用同帧，自动转向关闭。短测不代表持续达到请求的 60 fps。
软件回归 | 47 项相关测试通过 · 无新增回归全套 252 项，仍保留此前 24 个失败、2 个错误。覆盖稳定采样、倾角去重、预览开关和距离输出隔离。

查看原网页的实时对齐状态与原图开关

查看本轮候选姿态总览

本轮先完成图像对齐预览，不再要求连续补拍。正式测距仍需要平面更稳定、几何可复核的标定数据和已知距离验证；相对行对齐不代表房间绝对水平已标定。

### 2026.10.25 · 现场诊断与离线对齐

R08 历史诊断 · 正式标定未通过

36 组手持候选，29 组拟合、7 组留出。拍摄距离只需大概变化；当前对照图来自已保存样本，未加载到实时程序。

图像对齐 | 留出行误差 P95：1.74 px以原相机平均焦距统计；门槛 <2 px。公共有效矩形 1785×1015，投影矩阵同步更新。
未通过项 | 右目投影 P95：5.10 px（需 <3）单目 RMS 1.72 / 2.10 px（需 <1.5），双目 RMS 2.11 px（需 <1.8）。未放宽质量门槛。
算法修正 | 联合细化 / 原焦距画布 / 诊断参数拒载初始内参不再直接固定；限制高阶外推；缩小预览不能人为降低误差。
回归验证 | 新增测试累计 37 项通过全套 242 项，保留既有 24 个失败、2 个错误，无新增回归。
实机状态 | 仅离线预览 · 深度和自动转向关闭纸面平整度与距离精度未核验；约 40/50/60 cm 不作为测距真值。

稳定性补查：329 张原始照片中，按相邻两段运动均不超过 5 px/s 的本次筛选规则，32 张属于低运动帧，去重后仅 3 个不同姿态；不足 20 组，未据此重算。该旧筛选规则与结果仅作历史记录；R09 已修正实时稳定判断并完成新一轮采集。

查看原始 / 离线对齐对照图（测距未通过）

### 2026.10.25 · 打印图手持试拍

R07 历史试拍记录

采集条件 | 纸张手持 · 约 50 cm距离由用户口述，为约数；纸面平整度和打印尺寸未核验。
候选样本 | 保存 5 组同帧双目每组识别 12–18 个共同角点；两眼均能识别实际打印图。
主要限制 | 数量与横向覆盖不足当前至少需要 20 组；已保存样本主要集中在画面中下部。左半幅检出的角点较少，检测方法对照仅在离线进行。
实机状态 | 试拍已暂停 · 校正与测距未启用没有将近似距离、未确认尺寸或临时检测参数作为有效标定。

下一轮可用平整硬壳书或文件夹抵住纸背，无需胶带；保持图案平整，补充左右、上下、距离和倾角变化，并用直尺核对打印尺寸。

### 2026.10.25 · 标定工具已准备

R06 历史准备记录

打印板 | A4 · 7×10 格 · 每格 20 mmChArUco；源图及 PDF 渲染图均识别 54 角点、35 标记。打印后仍需直尺核对尺寸。
原网页入口 | 打印下载 / 自动采集 / 暂停续拍 / 质量检查至少 20 组，建议 30–40 组不同位置和倾角；自动转向关闭。
计算链 | 共同立体校正 → 同一有效矩形 → 稀疏三角化裁切与缩放同步更新投影矩阵；真实质量检查通过后才加载。
代码验证 | 新增 34 项通过全套 239 项，保留原有 24 个失败与 2 个错误，无新增回归；含合成滚转校正和 2 m 纹理平面。
实机验收状态 | 准备时 0 组样本 · 校正和深度未启用当前仍为双目二维识别；右目相对倾斜、真实距离精度及校正后性能等待采集和实测。

纸张整张平贴到平整硬板，手持在两只镜头前移动；不贴到人头上。两镜头安装、焦点或分辨率改变后须重新标定。

下载 A4 标定板 PDF

查看原网页标定入口（实物采集尚未开始）

### 2026.10.25 · 两眼共同识别

R05 历史实采

完整双目采集 | 49.64 fps1492 帧 / 30.054 秒；3840×1080，预热后测量
两侧检测 | 近期 16.30 对/秒两眼各 1920×1080 输入，共用 SCRFD GPU 会话；身体辅助检测降频
数字遮挡回放 | 5 类检查通过原始双眼检测、遮左用右、遮右用左、双遮清理、恢复检测；使用真实样张与模型
原始音频 | 1442880 个四通道采样帧48 kHz / 16 bit RAW WASAPI；0 溢出、0 录音丢块；仅两耳进入定位
代码回归 | 新增 22 项通过全套 205 项，原先 24 个失败与 2 个错误保留，无新增问题
控制边界 | 自动转头保持关闭测试期间没有打开舵机串口；实物遮挡、机械效果及立体标定待验证

跨目外观关联仍为暂定结果，模糊或相似观察保持分开。当前观察使用选中相机坐标，尚不输出标定深度和统一物理角度。数字遮挡通过不等于实物遮挡已验收。

查看原网页左右检测框与处理状态

### 2026.10.21 完整双目到帧基线

33.12fps

约 30 秒连续测试

请求驱动档位

60 fps

实际接收

33.12 fps

3840 × 1080 原始 MJPEG · 995 帧 / 30.042 秒观察窗口

### 2026.10.21 四通道连续录音基线

0次溢出 / 录音丢块

约 30 秒连续测试

CH 1CH 2CH 3CH 4

4 × 48000 Hz × 16 bit PCM · 1441920 个录音采样帧

### 2026.10.24 · 多距离视觉与实物水平基准

R04 历史记录

完整双目采集 | 33.09 fps497 帧 / 15.019 秒；模型至少完成十帧后开始测量
视觉处理 | SCRFD 全图 + 局部小脸搜索近期 19.31 fps；室内背景，未验证近远距离准确率
原始音频 | 4 通道 / 48 kHz / 16 bit720960 个采样帧；0 缓冲溢出、0 录音队列丢块
真实对焦能力 | MF 手动调焦；Focus / Zoom 不支持局部预览与清晰度分数已接入；当前没有可执行的光学自动对焦
水平与俯仰方向 | Pitch center = 1553；数值增大为抬头实际五次反馈取中位数；没有写硬件零点。左右间歇回包仍未确定原因
视觉回归 | 新增 11 项通过全套 183 项，保留原先 24 个失败、2 个错误，没有新增回归

查看原网页实机界面截图

软件多尺度检测不会改变镜头焦点。自动对焦需要可控调焦机构；近远场清晰度与检测效果、双目深度、声学精度及舵机全程顺滑度均待后续实测。自动转头保持关闭。

### 2026.10.23 · 头部实物接入验证

R03 历史记录

主程序完整双目 | 33.16 fps498 帧 / 15.02 秒；原始左右各 1920×1080，0 张尺寸错误 JPEG
有效画面二维处理节拍 | 26.47 fps室内背景场景；不代表多人检测性能或测距精度
算法音频输入 | 左耳 CH3 / 右耳 CH2CH1 / CH4 不参与方向、频谱门控或 ASD；原始四路录音保留
采集质量修正 | WASAPI RAW 共享 · 48 kHz / 16 bit普通共享流四路近似相同；RAW 共享后独立变化。本次 0 缓冲溢出、0 录音丢块
新增测试 | 14 项通过全套 161 项，原先 26 个问题保留，未新增历史回归
舵机当前状态 | COM3 / ID 0、2 初始查询成功小幅测试中反馈中断；已停止动作。方向和物理顺滑度尚未确认，自动控制保持关闭

### 2026.10.21 · 帧率排查记录

60 fps 尚未达到

摄像头不同模式原始 MJPEG 到帧测试

USB 已协商为 HighSpeed USB 2.0；以上测试不经过视觉模型或重编码，曝光测试后已恢复原设置。限制已出现在当前主机原始接收路径，具体设备或驱动原因仍未确认。

### 2026.10.21 采集与算法节拍基线

运行时验证

左目模型处理近期节拍 | 32.83 fps当前测试场景接近全黑，无检测目标
后台总控近期节拍 | 30.001 Hz目标 30 Hz，不依赖浏览器连接
原始帧完整性 | 0 张尺寸错误 JPEG
退出释放 | 控制线程、相机、音频均已关闭串口从未打开

上述处理速度只代表当前场景，不能外推为有人脸或多人场景性能。音画时间戳仍未完成曝光 / ADC 偏移标定。

### 连续运动的离线回放

实际新轨迹代码 + 虚拟执行器 · 9 秒 / 451 个规划采样点

2026.10.21 离线基线

位置与目标速度连续性加速度连续性

轨迹采样 50 Hz，实际生成 183 条位置命令，时长 T40 ms。规划最大速度 180.00、加速度 266.04、jerk 1734.45，均在 180 / 600 / 3000 上限内；单位为舵机刻度及其时间导数。实物顺滑度仍待稳定通讯后验证。

以下更新为 2026.10.23 实物接入后的双目样张（逐眼旋转 180°）和 RAW 逐耳识别录音片段（右耳轻擦，原记录第 27–30 秒）；原始未旋转 JPEG 和完整录音留存于证据目录。上方 2026.10.21 记录作为历史基线保留。

### 双目方向修正样张（公开版已隐藏）

3840 × 1080 · 左右拼接 · 静态测试帧

原始记录

完整双目左目右目

LEFT + RIGHT / 3840 × 1080

左右各 1920 × 1080，保存在同一输出帧中。

本次主程序实采，左右半幅分别修正安装方向；未做立体校正。原始未旋转 JPEG 留存在证据目录；当前背景场景不作为人脸检测或测距精度评测。

### 四通道录音样例（公开版已隐藏）

WASAPI RAW 共享 · 48 kHz / 16 bit

原始记录

3 秒全段40 毫秒细节

0.000 — 3.000 sCOMMON SCALE · DISPLAY GAIN

公开版不包含该次逐耳识别录音或波形。历史测试中 CH2 为右耳、CH3 为左耳。此历史片段采集时身体 CH1/CH4 尚未参与；R44已接入身体两路，当前映射以R44说明为准。本片段用于通道识别，不代表语音定位精度。

验证结果与边界

R15 的 378 项软件回归通过，原26项均处理且无跳过。R16在相同算法代码下确认重插后RAW采集恢复，并保存最新耳位：左CH2、右CH3；人声活动可检出，声音方向稳定性仍未通过。多人选人、声学角度、正式测距和机械顺滑度仍待验收。

05 / Completed work

## 这一轮更新，已经落到哪里。

只记录已完成、可以找到依据的工作。后续成果完成并验证后，再附加到这份报告中。

完成记录 / R49

头部实物已接入；RAW四路采集、身体两路协同与左右目共同识别已接入；四麦实物测角仍待确认，原网页展示两侧检测与选择状态。俯仰方向与水平基准已由现场确认；自动对焦硬件条件、双目深度、声学精度与运动全程仍待完善。

HEAD BRING-UP / R49

展开数据来源与版本依据

公开版保留设计预览、统计、算法说明和脱敏后的历史记录；现场图像与录音不随仓库发布。本轮完整录音与原始记录保留于本地证据目录。工作区代码以文件 SHA-256 对应，基线为 44fd319 · R48运行 / R49源码待载；本页是制作时快照。 公开证据清单中的文本SHA-256在LF换行归一后计算。

DEEPSIGHT-3D / PROJECT PROGRESS REPORT2026.10.28 · R49 · 硬件采集与软件现状记录

← 上一节下一节 →退出 · Esc

DeepSight-3D · 算法交互详解 源码摘录 / 离线状态推演 / 视觉纠偏关闭
