CatLiZi/DeepSight-3D/docs/report/primary-modes-r52.html

R53控制修复：回中与手动轨迹不再被暂停期间的感知逻辑取消。 统一服务端回中入口，保留Stop/反馈/行程保护。918项Python、127项前端检查通过，用户已确认回中正常，位置反馈有效。修复依据与复核步骤

DEEPSIGHT · CONTROL POLICY · 2026.11.05

# 谁来决定转向， 现在可以明确选择。

R52：听声转头与视觉跟踪互斥；两种模式均保留四麦与双目采集。

实现完成 · 软件验证通过

当前文件记录源码与离线验证状态。是否已加载，以控制网页显示的 R52 和 /api/state 为准。实机两人交替、移动、噪声干扰尚待验证。

本机重启后只读核验：R52 已加载，当前为听声主导；四通道 48 kHz / 16-bit WASAPI RAW 采集正常，缓冲溢出为0，双目在线。自动转头保持暂停，未下发动作；舵机位置同步与实机两人切换尚待开始运行后的现场验证。

## 01 · 这次解决什么

旧流程将已锁定的可见人脸持续作为控制拥有者。另一方向虽能显示声音，仍可能因为“视觉优先”没有接管转动。两个勾选框也没有明确区分谁主导，造成选择与控制不一致。

## 听声转头

声音主导 · 视觉可被打断

可靠声源决定绝对转向目标；转近该方向后，从声音扇区内寻找人脸。视觉负责精细居中和连续跟随。新确认声源可以撤销旧视觉动作并重新接管。

## 视觉跟踪

视觉主导 · 声音辅助选人

沿用稳定视觉目标选择；可靠声音帮助在可见人脸中选人。没有声音或声音与可见目标不匹配时，仍保持视觉跟随。

## 02 · 听声模式的数据与控制流程

① 四麦人声与方向复用现有 VAD、时差质量和姿态转换

→

② 确认核心声源按语音时长、可靠性和近期证据形成目标

→

③ 完成有限转向沿原平滑轨迹分步接近；短暂停顿不取消目标

→

④ 视觉修正只接受声源范围内的新鲜人脸，双目共同跟随

新声源确认 → 打断④ → 返回③。后台画面携带声源编号与控制轮次；旧画面不能把已经失去控制权的人脸重新交给电机。

声音位置是带误差的水平估计，不是身份识别或声学测距；人脸大小仍只表示相对视觉大小。

## 03 · 规则与边界

情况 | R52 行为
无可靠声音，但画面有人 | 听声模式等待声音，不自动挑最大人脸；视觉模式仍可跟随。
转动中说话结束 | 完成已经确认的有限目标，不将历史相对角反复叠加。
转近声源方向 | 进入约 ±12° 的接近范围后，按声音扇区（默认 ±15°，使用整张脸的角度区间）关联新鲜人脸。需连续画面确认。
声音已停，尚未找到脸 | 到达附近后保留约2秒的人脸获取窗口；窗口结束保持该方向，等待新声音。不会无限期把后来路过者当作旧说话人。
已经关联的人脸继续移动 | 使用原有动态速度与平滑控制跟随，声音短暂停顿不会让其丢失控制权。
另一可靠声源确认 | 撤销旧视觉轨迹，转向新声源；不因旧人脸还在画面中而拒绝切换。
人脸短暂遮挡 / 丢帧 | 不使用旧像素继续追赶；约0.7秒内等待同一目标恢复。长时间丢失且没有新声音，不恢复旧位置搜索。
停止 / 模式切换 / 舵机故障 | 沿用原有撤销、反馈与行程保护。切换模式清除旧控制目标；未重新获得新证据不开始旧动作。
双目自检明确失配 | 听声定位可继续，视觉辅助控制停用，避免用失配画面驱动微调。

## 04 · 验证与真实完成度

903

Python 回归通过；包含28项新增优先级测试和1项录制读写竞争测试。

122

前端检查通过；模拟网页确认互斥切换、保存结果和录制入口。

本轮使用合成方向、模拟电机、双目目标轨迹和故障反例，未驱动实物舵机、未采新录音。没有改变声学阈值、阵列通道、视觉检测参数、舵机行程和轨迹限制。

同时修复录制导出状态文件在 Windows 上读写竞争导致的偶发文件占用。录制时间线现在保存所选优先模式、视觉辅助阶段与切换原因。

这证明控制逻辑按设计执行，不代表现场声源角度、多人区分或机械响应已验收。两人同时说话时仍选择主方向，不能保证语音分离或身份识别。

## 05 · 一分钟现场复核

1. 正常重启并 Ctrl+F5 刷新，确认 R52。先检查两轴反馈，再开启摄像头与“听声转头”。
2. A与B在两侧，先由A正常讲话，观察转向与人脸微调。A停说，B讲话；旧人脸仍可见时，应转向B。
3. B缓慢移动，看视觉辅助是否跟随；A重新讲话，观察新声源是否能接管。
4. 换成“视觉跟踪”重复简短对照，确认安静时仍可视觉跟随。
5. 使用60秒录制保存画面、四路音频与决策时间线。左右是小熊自身左右，不把大致站位当精确角度。

## 06 · 当前模块与框架图交接

现行系统应画成：双目视觉和四麦听觉并行感知 → 可靠证据与核心声源记忆 → 互斥的听声主导／视觉主导 → 共用平滑控制与反馈。D1录制位于旁路，不启动运动。

本次文档已更新

模块输入输出、源码对应、听声状态、接管保护、坐标转换和验证边界均已核对。

框架图待另一agent重绘

原R51图保留为历史参考。新图必须体现新声源打断旧视觉辅助，并同步更新SVG生成器。

阅读R52模块说明 · 复制完整制图提示词

本轮仅整理说明与交接，未修改执行算法、标定、舵机或Blender模型；没有新增实物验收结论。

DeepSight · 本页可离线阅读 · R52 软件验证记录
