CatLiZi/DeepSight-3D/docs/assets/microphone-holder-reference.png

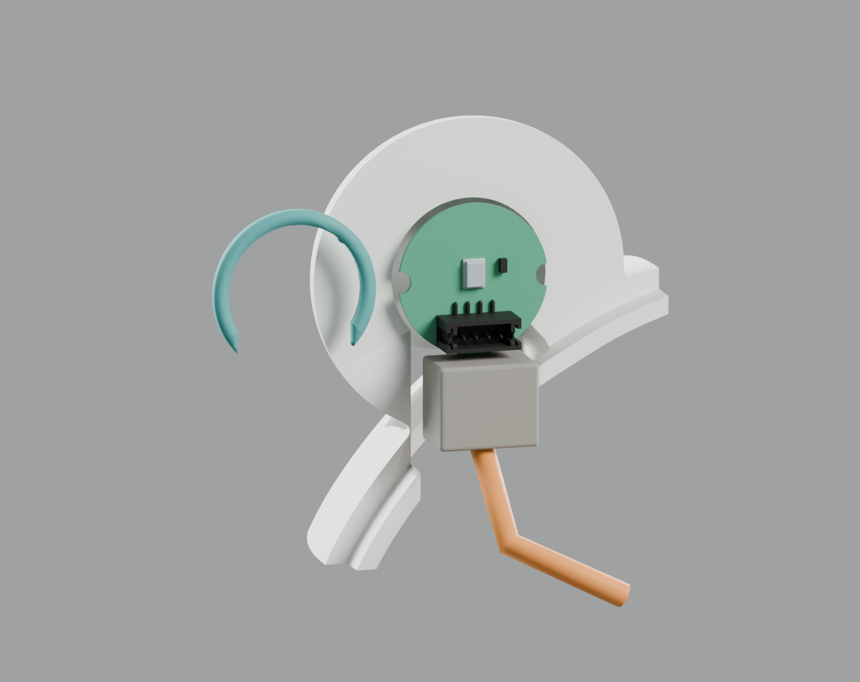
docs/assets/microphone-holder-reference.png
