CatLiZi/DeepSight-3D/hardware/drawings/reference/head_base_axes.png

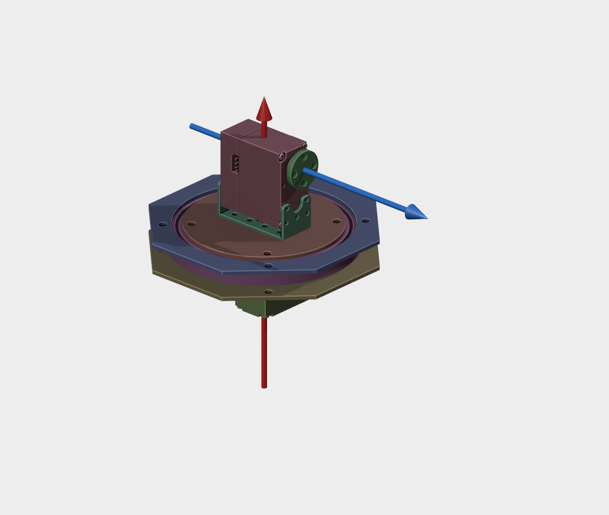
hardware/drawings/reference/head_base_axes.png
