CatLiZi/DeepSight-3D/(list of files, cad)

Other CAD files:
hardware/cad/body_shell/panda_body_V25_shells_V16_cylinder.blend
hardware/cad/head_shell/panda_head_only_V17.blend
