CatLiZi/DeepSight-3D/hardware/drawings/reference/assembly_overview.png

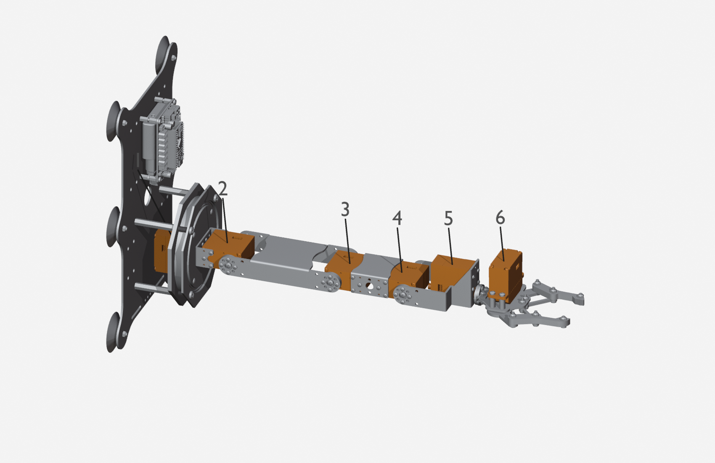
hardware/drawings/reference/assembly_overview.png
