CatLiZi/DeepSight-3D/docs/SERVO_CALIBRATION_CN.md

# 舵机现场记录（2026-10-24）

## 2026-10-26：左右软件范围800–2200（R14）

用户指定左右轴扩展为800–2200，中位1500。上下轴保持1200–1800、水平基准1553。范围已贯通默认配置、已保存配置、位置同步、逻辑/轨迹/发送层、诊断接口及网页；通用串口编码器仍按配置上层区分Yaw/Pitch，不将特定舵机ID写死成某一轴。

原网页新增Yaw min/center/max，预设由后台按当前范围与方向生成：当前左后800、左前1150、中1500、右前1850、右后2200，俯仰均使用1553；更改方向或非对称范围后重新计算。范围保存会暂停运动，重新取得反馈后再启动。诊断直接运动接口也校验对应轴范围，不能越过软件限位。

运动速度、加速度、jerk、50Hz采样和单次跟踪步长保持原配置；总行程与单轮声音搜索窗口分别处理。新范围通过离线端点、越界、连续轨迹、串口编码与网页绑定检查，没有执行实物800/2200端点动作，也没有确认机械极限。以下较早记录中的范围为当时设置。

## 2026-10-26：间歇反馈与自动俯仰触发

只读实测曾出现两轴均无回复，重开同一COM3会话后均返回1504；随后又出现ID0正常、ID2无回复，而用户上下箭头能够动作。之后两轴连续三轮查询恢复，ID0约1500、ID2为1561。没有证据将间歇故障确定归因于供电、线缆或固件。

新版已加：位置读请求三次有界重试、过滤回显和错误ID；静止时最多重开一次串口并重新读全部所需轴。运行时约每秒查询实际位置，单轴连续两次无有效反馈即停止控制，必须重新取得有效反馈才可再启动。IO错误锁定，不自动重放旧目标；停止操作能取消正在进行的启动。

自动跟踪默认俯仰进入阈值0.04、释放阈值0.024，分别约占画面高度2%、1.2%；连续两张新画面、同向至少40ms确认。用户显式门槛仍生效。页面显示逐轴触发原因和限位状态。保留pitch中心1553、1200–1800数值范围；本机visual_mirror_x=true按用户实际反馈修正自动左右方向，手动方向符号保留。

新版±30刻度小步实机测试：下1561→1536，上1536→1558。此测试验证实际俯仰响应，不等同于完整自动人脸跟随或角度精度验收。此前目标值曾为1800，不能将目标值当作实际位置。

每次运行追加`logs/runtime.jsonl`与`logs/serial.jsonl`，各5MiB、四份轮转备份；保存时间、会话/请求编号、错误、串口帧和耗时，不保存音视频内容。两类日志均可从原网页下载；历史现场记录保留在`../hardware_inventory/servo-feedback-20261026/`。发生问题时先查看`motion_sync_error`、`motion_feedback_error`、`serial_request`的outcome和原始回复，不关闭位置反馈保护。

继续使用原项目 `run_server.py` 与完整网页。单独制作的简化调试页已退出，原始记录保留。

- COM3 / CH340 / VID 1A86 PID 7523；ID 0 为左右轴，ID 2 为俯仰轴。用户确认 ID 2 数值减小时低头，软件 `pitch_up_sign=+1`；`yaw_left_sign=-1` 保留。
- 用户指出当前姿态为水平朝前，五次只读位置为 1553、1553、1553、1554、1553，取中位数 **1553** 保存为软件 `pitch_center`。回中按钮、中间圆点及左右预设同步使用该值，没有写硬件零点或开机 EEPROM。
- 手动方向键先停止原轨迹、读取指定轴实际位置，只启用这一轴；另一轴缺失不妨碍测试，但双轴姿态和自动控制仍需完整反馈检查。
- 原网页增加只读位置按钮，区分目标和实测；可对照原始单条定时指令与 50 Hz 连续轨迹。本机当前选原始方式，手动点动 900 ms。

## 间歇反馈尚未确定原因

最初两轴三轮查询稳定；小幅连续发令测试中 ID 0 反馈中断。后续静止时 ID 0 连续十二次 PRAD 无回复、ID 2 六次全正常，PID 扫描仍可找到两轴。退出网页串口会话后，只读探测再次读到：ID 0 版本 `ZL-ZServo_AD_CBM V2.1.16STG`、MOD1、位置 1504；ID 2 版本 `V2.1.8STG`、MOD1、位置 1553。用户随后反馈左右恢复。

不能据此认定故障根治，也未证明供电、50 Hz 发令或某个固件版本是原因。没有以目标值替代缺失位置继续运动。范围 1200–1800 是软件边界，不是已测机械极限；大幅全程、负载下通信与实际顺滑度尚待验证。

本次舵机与网页新增 11 个离线用例通过，全套 172 项保留原先 26 个问题，没有新增回归。位置回包、小幅失败、网页操作与水平取样见 `../hardware_inventory/servo-validation-20261024/`。
