CatLiZi/DeepSight-3D/docs/STEREO_CALIBRATION_CN.md

# 双目标定、公共有效裁切与三维目标（2026-10-25）

## 当前实机状态

R10 已更新求解与匹配软件：真实采集有时间戳时，按 4 秒采集片段分组，每五组留出一组，并隔离验证边界前后 0.7 秒的训练帧；独立训练/验证数量不足时拒绝计算。没有时间戳的独立照片仍按每五张留一张，但显式记录“时间隔离未核验”。

联合估计增加 Soft-L1 抗异常点优化（1.5 px 软阈值，固定 k3=0），同时优化两眼内外参与训练板面姿态。训练角点全部保留，训练 RMS 仍按未加权误差统计；验证图像与角点不参与拟合、不按误差删除。未收敛或训练几何位于镜头后方时拒绝激活。每个姿态保留跨目投影误差、两眼平面拟合误差及全部角点残差；平面警告不能确定是纸弯、运动、检测还是镜头模型误差。

历史 83 个姿态在新的同一 65 训练 / 18 验证划分下，普通估计投影 P95 为 4.735 px，Soft-L1 为 4.560 px；行对齐 P95 从 1.602 降至 1.508 px。新模型仍为 rejected（左 RMS 1.531 px，超过 1.5；投影 4.560 px，超过 3），未替换 R09 对齐预览。这是开发回放，不是新采集的独立实物验收；与 R09 的 67/16 划分不能直接比较来声称精度提升。

空间匹配增加亮度归一化局部纹理相关、二维分布覆盖和共线检查，并估计小视差带来的深度测量噪声；估计不包含标定、打印尺度或镜头模型误差。特征集中于小块、纹理不一致或相对测量噪声过大时返回无距离，并记录原因。该计算链已通过软件/合成几何验证，实机仍因正式标定未通过而禁用距离输出。

R10 证据目录：`hardware_inventory/stereo-geometry-refinement-20261025/`。累计 60 项相关测试通过，全套 265 项保留原有 24 个失败、2 个错误，无新增回归。

## R09 对齐预览与采集来源

最新一轮已检查全部 235 张板面存档：先从最新向前检查角点，再按真实时间顺序计算运动。188 张至少有 12 个共同角点；网页本组保存 15 组稳定样本。存档稳定帧与本组去重后有 17 个稳定姿态，未达到正式计算所需的 20 组，未用这个严格子集拟合。

另对全部角点合格帧按位置、尺度、透视差异去重，优先角点较多的视图，得到 83 个探索性诊断姿态（包含不满足稳定窗口的帧；没有按模型残差挑样本）。67 组拟合、16 组留出。左右 RMS 为 1.486 / 1.345 px，双目 RMS 1.566 px，留出行误差 P95 为 1.643 px；留出右目投影误差 P95 为 5.780 px，仍超过 3 px 门槛。打印尺度和平整度未完全核验，距离约数不作为真值。

已在原网页启用 **仅画面对齐预览**，修正两眼相对倾斜、畸变并裁取同一个有效矩形：每眼 1836×1050，保留原像素面积约 92.97%。勾选“使用已有双目校正参数”可恢复预览，取消可对照原图。原始 3840×1080 MJPEG 不裁切；20.22 秒主机接收窗口为 1003 帧、49.60 fps。该短测不代表持续达到 60 fps。

预览文件为 `calibration/stereo_camera-alignment.json`，源正式检查的 rejected 结果完整保留；默认三维加载器拒绝预览文件，预览需显式 opt-in。运行时 `calibrated=false`、`metric_ready=false`、`stereo_depth_enabled=false`；不提供 Q 或三维投影接口，稀疏几何匹配直接返回空结果。正式 `stereo_camera.json` 尚不存在。两眼继续各自检测/跟踪，音频及视觉自动转头保持关闭。相对极线对齐也不代表相机与房间或底座的绝对水平已经标定。

## 前轮记录（R08，历史状态）

现场先保存 5 组手持候选，再试验约 103 cm 贴墙画面，随后在约 40–60 cm 范围完成 36 组手持候选。距离均为用户估计范围。

36 组按 29 组拟合、7 组留出验证。联合细化后的行对齐误差 P95 为 1.74 px，留出右目投影误差为 5.10 px（门槛 <3 px），单目 RMS 为 1.72 / 2.10 px（门槛 <1.5 px），双目 RMS 2.11 px（门槛 <1.8 px）。结果仍未通过正式标定；仅生成已保存图像的离线对齐预览，未加载实时程序，深度和自动转向未启用。

另对 329 张保存的原始照片进行运动筛选：本次采用相邻两段运动均不超过 5 px/s、至少 12 个共同 ID 的规则，32 张满足低运动条件，姿态去重后只有 3 组，因此没有用它们再次拟合或放宽门槛。下次每个姿态建议停稳 4–5 秒，并减少纸面弯曲；40、50、60 cm 仍只需近似范围。

## 打印和装板

- 打印文件：DeepSight-3D 根目录的 `output/calibration/stereo-charuco-A4-20mm.pdf`。
- A4 纵向、实际大小 / 100%，关闭适应页面，保留整张白边。
- 棋盘为 7×10 格，格子 20 mm，标记 15 mm，DICT_4X4_100；实际棋盘区域 140×200 mm。
- 用直尺检查页脚两端为 100 mm、单格为 20 mm。如统一缩放过，网页填实测格长，不能仍按名义 20 mm 计算距离。
- 纸张平贴到稍大于 A4 的硬纸板、泡沫板或亚克力板上，避免起皱、弯曲和反光覆膜。手持硬板移动，不贴在人头上。

## 采集操作

1. 固定两只镜头的安装和手动焦点；镜头、支架、焦点或方向改变后重新标定。
2. 打开原网页“视觉跟踪 → 双目标定、倾斜校正与空间定位”。填实测格长，核对后勾选尺寸确认。
3. 开始自动采集。程序停止自动转向；每约 0.7 秒检测一组原始同帧双目。共同角点至少 12 个、稳定观察至少 1.4 秒且姿态有变化才保存。每处停稳 4–5 秒；不必精确量出拍摄距离。稳定检测用原像素速度与至少 4 个非共线共同轨迹，不能用固定像素位移混淆不同采样间隔。
4. 先从约 0.4–0.8 m 开始，以两眼都能看到清晰角点为准。让板覆盖画面左、右、上、下，改变距离，并向不同方向倾斜约 15–30°。不要只平移一张始终正对镜头的板。
5. 至少 20 组，建议 30–40 组。观察保存计数和提示，暂停采集后计算标定。预览为最近保存的样本，不是实时角点视频。
6. 质量检查通过后自动加载校正。未通过时用“继续本组采集”补充不同姿态；本组沿用已确认的格长。若安装、焦点、打印板或尺寸改变，请开始新一组重新采集，旧文件仍保留。不能将未通过结果用于空间定位。

## 几何处理

原始 USB 双目帧 → 分眼/方向修正 → 左右初始内参 → 联合细化内外参（固定 k3=0，限制高阶外推）→ 留出样本验证 → 两眼共同立体校正 → 公共有效矩形 → 更新投影矩阵 → 独立检测与稀疏对应 → 三角化目标表面。

校正不使用目测角度、房间中的斜线或 CAD 名义基线代替实测。`stereoRectify` 使用 alpha=-1，保持接近原始焦距的公共画布，再从两眼映射有效掩膜取最大公共矩形。此次试验中，alpha=1 会因边缘畸变外推将画布焦距缩到约 96 px，导致有效矩形只剩 205×115；新版画布约 879 px、公共矩形 1785×1015。裁切后两眼投影矩阵同时扣除裁切原点，处理缩放也同步更新矩阵。画布裁切面积占比不是实际角度视野保留率。

## 质量门槛与记录

每五组留一组，不参与内外参拟合。检查单目 RMS、双目 RMS、留出极线误差 P95、从左目位姿预测右目后的重投影误差，以及位置、距离、板面法向变化。极线误差使用校正归一化坐标乘以原相机平均焦距，避免缩小预览画布人为降低误差。当前阈值保持不变：单目 RMS <1.5 px、双目 RMS <1.8 px、留出极线 P95 <2 px、留出投影 P95 <3 px；这些是加载门槛，不是现场距离准确率保证。

`diagnostic_only=True` 可对未确认尺度的样本进行诊断，但结果保留 `metric_scale_confirmed=false` 与专用来源标签；正式运行时拒载诊断参数。只有相对图像质量检查通过后才能显式生成独立的 alignment-preview 参数；它不改变正式拒绝结果，不启用距离。手持纸的平整度未核验，不能把低行误差或大概拍摄距离当作空间精度证明。当前来源：`hardware_inventory/stereo-stable-round-20261025-172159/`；前轮来源仍保留。

相机尺寸和安装方向绑定标定文件；有 USB 身份时一并校验。合成测试标定无法加载到真实运行时。真实采集保存在 `calibration/sessions/`，通过后文件为 `calibration/stereo_camera.json`。目录为本机生成数据，不提交 Git。

## 空间目标与控制

在校正后的两幅图中，先对候选人脸区域做稀疏特征匹配，使用前后向一致性、极线误差、视差方向、ROI 范围和重投影约束筛选。至少 8 个一致点后估计三维表面中心，深度离散过大、低纹理、歧义或缺失另一眼时不输出距离。当前每眼最多为 4 个高置信人脸计算空间候选，所有人脸仍保留二维检测。

三维位置以两相机中点的校正坐标系为基准：X 向图像右、Y 向下、Z 向前，单位米；不是房间世界坐标或已标定的机器人底座坐标。显示高低时使用 -Y。两眼共同估计出的空间方向进入既有的有界视觉纠偏。三维与二维回退切换需要重新确认；单目观察仍作为降级路径。

稀疏人脸表面中心不是精确鼻尖或人体关节。完成实物标定后，还需要在已知位置/距离下验证误差；`known_distance_accuracy_verified` 当前始终为 false。曝光时刻和音画时延仍未标定。

## 已完成的离线验证

相关测试扩展到 60 项：R10 增加时间分组隔离、短片段不足、验证数据不进入拟合、异常点抗扰与未加权检查、所有验证残差保留、未收敛拒载，以及纹理亮度差、局部特征集中、小视差和距离噪声等检查。其余覆盖已知内外参、留出验证、滚转校正、裁切和缩放后的三角化、正负视差、纹理匹配、单目回退与网页入口。全套 265 项保留既有 24 个失败和 2 个错误，无新增回归。

另完成 20 秒实时双眼同帧处理、预览开关与距离关闭检查；这些不代表正式标定或真实距离精度已验收。

参考：使用 [OpenCV ChArUco 标定方法](https://docs.opencv.org/4.x/da/d13/tutorial_aruco_calibration.html)、[双目标定与立体校正](https://docs.opencv.org/4.x/d9/d0c/group__calib3d.html) 与 [SciPy 最小二乘的鲁棒损失](https://docs.scipy.org/doc/scipy/reference/generated/scipy.optimize.least_squares.html)。立体校正使两眼对应点的极线对齐；房间的绝对水平或机器人底座姿态需另有参考，不能仅凭背景斜线确定。
