CatLiZi/DeepSight-3D/output/calibration/stereo-charuco-A4-20mm.pdf

# 双目摄像头标定板

ChArUco 7 × 10 格；每格边长 20 mm

DICT_4X4_100 | marker: 15 mm | board: 140 x 200 mm

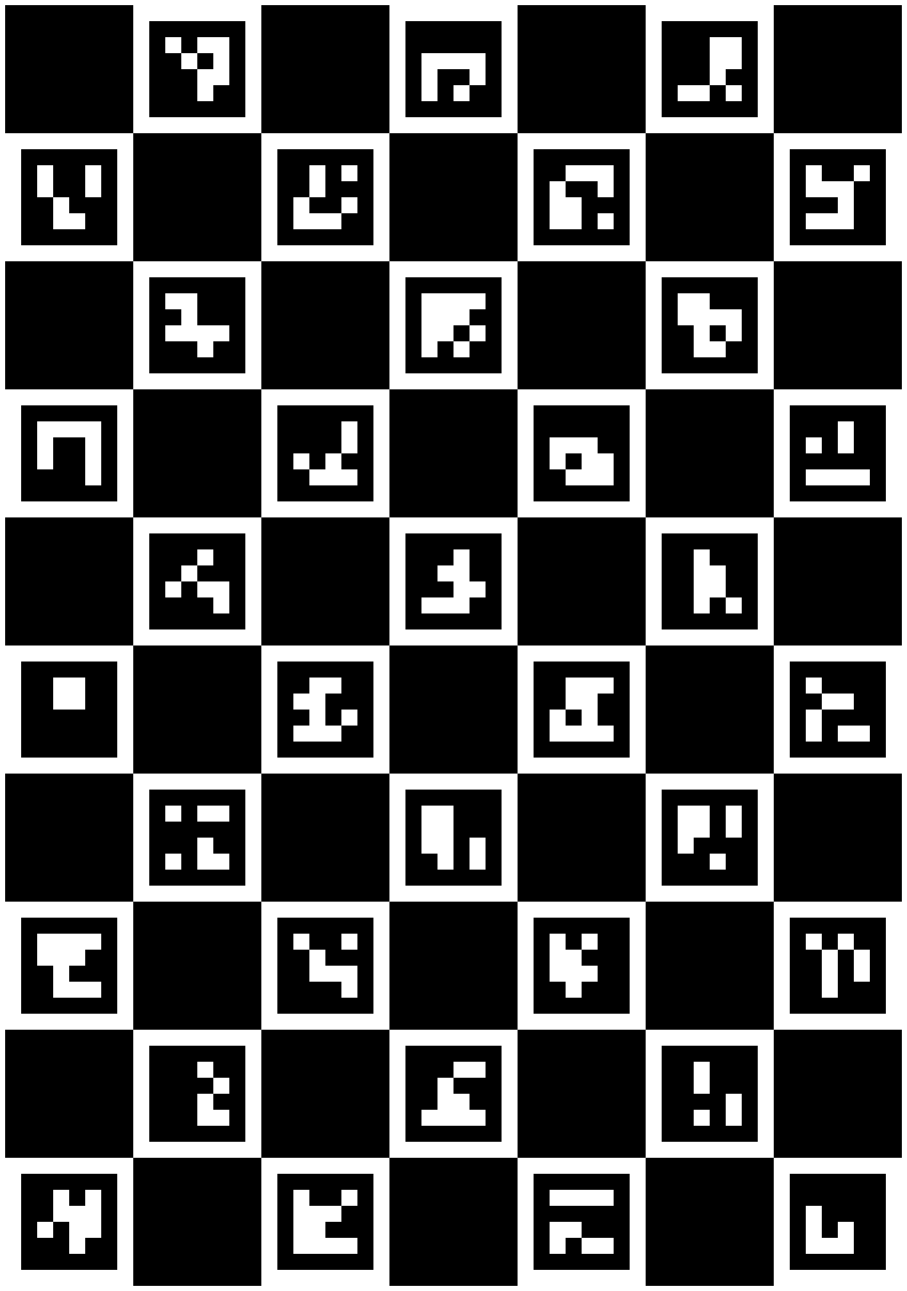
[picture p7: figure]

打印后核对：上方两端之间应为 100 mm；每格应为 20 mm。

A4 纵向，实际大小 / 100%；关闭“适应页面”，不要裁掉白边。

整张平贴硬板，不起皱、不覆亮膜；手持在两镜头前移动，不贴在人头上。
