CatLiZi/DeepSight-3D/docs/VALIDATION_R51.md

# R51 发布候选验证

> 本页保留 2026-11-04 的 R51 发布检查。2026-11-05 按项目要求仅脱敏两份 Blender 文件中的历史电脑路径并重新压缩；模型的当前哈希已更新到模型清单，Blender 5.2.2 LTS 重新打开后对象、网格、材质和依赖清单与脱敏前一致。下表是当时的历史验证，并非两次验证次数相加。

2026-11-05 的公开报告与配置复核：**859 项 Python 回归、104 项前端检查、240 组已知角度模拟通过**；公开报告增加了原始录音、用户路径与媒体脱敏检查。两份 Blender 文件的当前哈希通过模型清单校验。本轮没有实体舵机动作，模拟角度不代表实物定位精度。

## 2026-11-04 软件检查

在 Windows、本机既有 Python 3.11.17 环境的隔离检出目录运行，执行器为模拟或替身；未启动实体摄像头、麦克风录音或舵机动作。

| 检查 | 结果 | 覆盖内容 |
| --- | ---: | --- |
| Python严格回归 | 855通过，0失败，0错误，0跳过 | 包含原26项历史问题、R50几何、跨来源HTTP/WebSocket、配置与标定文件可移植性 |
| 网页检查 | 104通过 | 包含控制状态显示、声音范围、双目准星、设备状态与5项JavaScript语法检查 |
| 已知角度独立模拟 | 240组通过 | 两侧、两个速度档位、不同起点、软件边界与静音后分段完成；复用R50底层几何逻辑 |
| CAD源文件 | 两份与仓库模型清单的SHA-256一致 | Blender 5.2.2 LTS读取；渲染时未保存或修改源文件 |

复现命令：

```powershell
python -X utf8 tools\validate_regression_repair.py --output .tmp\release-tests
python -X utf8 tools\validate_frontend.py
python -X utf8 tools\validate_geometry_holdout.py
python -X utf8 tools\validate_publication.py --output .tmp\publication-check
```

`publication-validation-r51.json` 同时记录Windows测试工作区原始字节哈希和Git仓库blob的SHA-256；Git换行转换会使两者不同，不代表源码逻辑不同。

这些是软件测试，不是现场准确率。测试使用已经安装的依赖，**没有证明全新电脑可直接完成依赖安装**。Node.js用于前端检查；FFmpeg、驱动及可选GPU环境需在目标机器检查。

## 发现并修复的发布问题

1. 仅监听本机仍允许其他网页的跨来源表单触发无请求体的控制接口。R51增加本机Host和浏览器Origin检查，WebSocket同样检查来源；本地无Origin命令行客户端保持兼容。这不是本机进程认证，不应把服务暴露到网络。
2. 标定板PDF路径原本依赖仓库父目录；现在优先读取仓库内PDF，兼容旧目录回退。
3. 全量回归脚本和限位测试原本依赖仓库外历史文件或本机私有配置；现在使用仓库内的匿名测试ID与装配配置示例回退。
4. 新增当前装配示例，包括四麦通道和R50物理角度比例；示例默认关闭传感器功能开关，不覆盖已有设置。

## 尚未验收

- 本轮没有实物动作；R51安全检查需要操作者正常重启后加载，用户已反馈既有R50整体体验可用。
- 已有真实录音回放，但轻声、运动噪声、多人、远距离与准确角度仍需受控测试。旧合成谐波误方向问题不能因R49恢复分支无新增误方向而视为解决。
- 最终机械行程、偶发串口无反馈、头部转动后的全姿态四麦几何、正式双目测距尚未完成验收。
- 没有量角工具时，先验证小熊左/中/右、短句停止后是否继续到位及停止按钮；不把目测站位标作精确30°/45°。
- 用户现场录音、串口日志、个人配置和私有调试材料不包含在公开仓库中。
