CatLiZi/DeepSight-3D/output/calibration/charuco-7x10-20mm.png

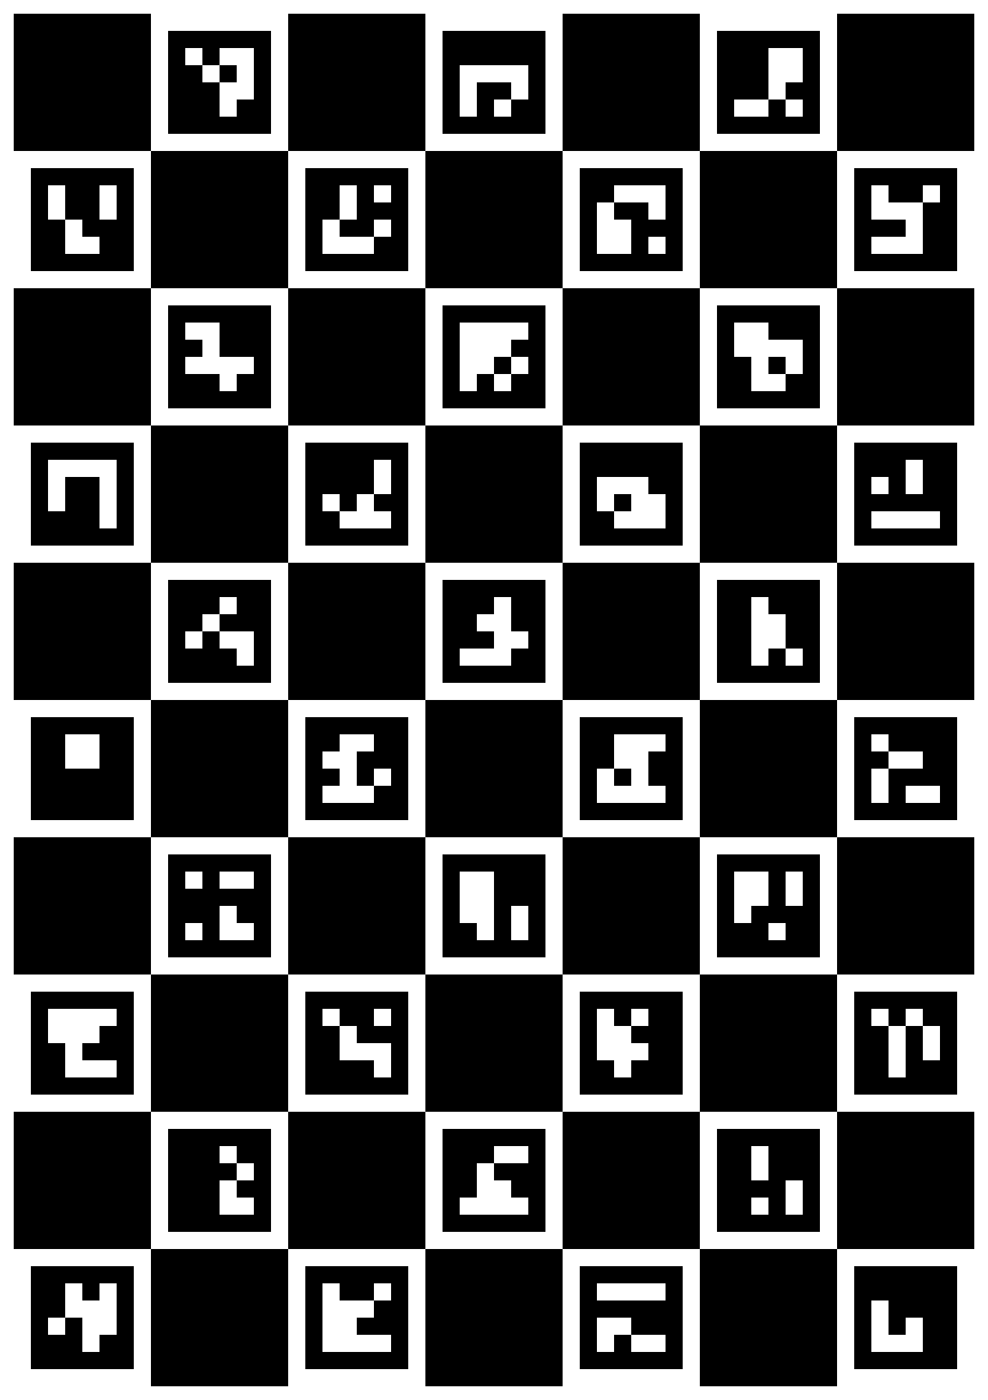
output/calibration/charuco-7x10-20mm.png
