CatLiZi/DeepSight-3D/(commit log)

2026-10-15 Initial commit: two-axis audio-visual speaker tracking robot
    A robot head that turns toward whoever is speaking.
    Sound direction comes from GCC-PHAT on a two-channel microphone. A camera
    supplies face targets, and an active-speaker backend (rule-based, or TalkNet
    on CUDA) decides which of several faces is actually talking. A state machine
    drives a two-axis servo bus over serial, and a FastAPI dashboard exposes
    every parameter along with a live preview.
    Layout:
    run_server.py entry point
    src/locator_demo/ core: audio, camera, vision, head control, servo bus
    src/locator_demo/web/ FastAPI app plus the dashboard front end
    models/ MediaPipe and SCRFD model files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
2026-10-15 Add a hardware/ folder for mechanical design assets
    Keeps the robot head 3D models, drawings and print exports in the repo
    alongside the code. It is deliberately not called models/ -- that name is
    already taken at the repo root by the MediaPipe and SCRFD AI model files,
    and reusing it would invite confusion.
    hardware/README.md documents the layout, the formats worth preferring
    (.step for interchange, .3mf for printing), a naming scheme, and the git
    caveat that matters most here: every revision of a binary CAD file is
    stored in full and permanently, so a few 50MB iterations will bloat the
    repo for good and GitHub rejects single files over 100MB.
    It also maps mechanical changes onto the cont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
2026-10-28 Add core mechanical references and enclosure handoff guide
2026-10-28 Update robot software to R43 with calibrated rig profile and regression suite
2026-11-04 Validate the current four-microphone release profile
